PAPRST/digitensk/README.md

# Digital Ten GHz Super Keyer
Modern system for digital mode on 6 and 3cm HAM band
