PAPRST/digitensk/FrontEnd/DualMixer/Converter_Head/oshpark_stackup.png

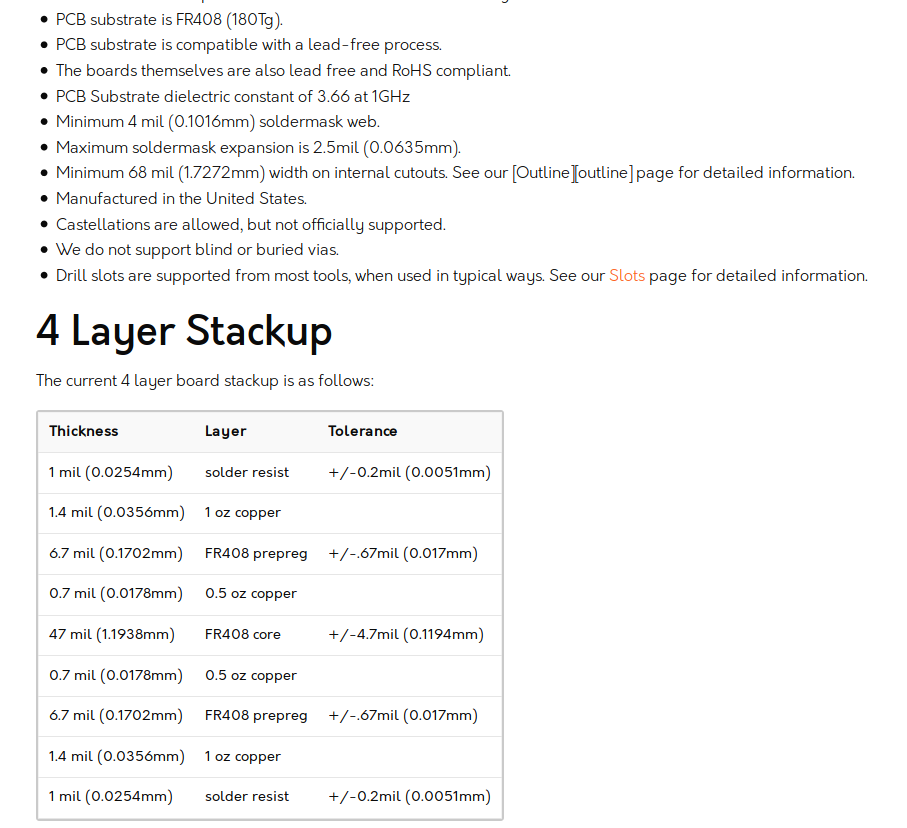
FrontEnd/DualMixer/Converter_Head/oshpark_stackup.png
