PAPRST/digitensk/FrontEnd/DualMixer/Converter_Head/Converter_Head_bom_1.0.csv

Component | Part | References | Value | Vendor | SKU | Footprint | Quantity Per PCB | Man. Ref. | Status
1 | CAP_0402 | C206 C208 C306 C308 | 0.15pF |  |  | SM0402 | 4
2 | CAP_0402 | C125 C127 C128 C129 C130 C131 C132 C133 C134 C137 C138 | 0.1uF |  |  | SM0402 | 11
3 | CAP_0603 | C114 | 1.68n |  |  | SM0603 | 1
4 | CAP_0603 | C410 C416 C417 C421 C422 C424 C430 C432 C437 | 100nF |  |  | SM0402 | 9
5 | CAP_0402 | C425 C426 C427 C428 | 100pF |  |  | SM0402 | 4
6 | CAP_0402 | C126 | 10nF |  |  | SM0402 | 1
7 | CAP_0402 | C135 C136 C411 C412 C418 C423 C429 C431 C433 C434 C435 C436 C438 | 10pF |  |  | SM0402 | 13
8 | CAP_1206 | C101 C102 C113 C116 C118 C119 | 10u |  |  | SM1206 | 6
9 | CAP_0805 | C103 C104 C110 C111 C401 C402 C403 C407 C408 C409 | 10uF |  |  | SM0805 | 10
10 | CAP_0402 | C415 | 1500pF |  |  | SM0402 | 1
11 | CAP_0402 | C419 C420 | 1n |  |  | SM0402 | 2
12 | CAP_0603 | C108 C109 C404 C405 C406 | 1nF |  |  | SM0603 | 5
13 | CAP_0603 | C203 C303 | 1uF |  |  | SM0603 | 2
14 | CAP_0603 | C107 | 2.8n |  |  | SM0603 | 1
15 | CAP_0402 | C205 C207 C209 C305 C307 C309 | 22pF |  |  | SM0402 | 6
16 | CAP_0402 | C201 C202 C301 C302 | 30pF |  |  | SM0402 | 4
17 | CAP_0402 | C414 | 33nF |  |  | SM0402 | 1
18 | CAP_0402 | C413 | 390pF |  |  | SM0402 | 1
19 | CAP_0603 | C112 | 4.7u |  |  | SM0603 | 1
20 | CAP_0603 | C105 C117 | 470p |  |  | SM0603 | 2
21 | CAP_0603 | C106 C115 | 47n |  |  | SM0603 | 2
22 | CAP_0402 | C204 C304 | 47pF |  |  | SM0402 | 2
23 | CAP_0402 | C444 C445 | CAP_0402 |  |  | SM0402 | 2
24 | CAP_0402 | C442 C443 C446 C447 | NC |  |  | SM0402 | 4
25 | LED | D101 D102 D103 D104 | LED |  |  | LED-0603 | 4
26 | BFCW | F201 F301 | BFCW-542+ |  |  | JC0603C | 2
27 | MINIC_HFCN | F403 F404 | MINIC_HFCN |  |  | FV1206 | 2
28 | MINIC_LFCN | F401 F402 | MINIC_LFCN |  |  | FV1206 | 2
29 | Conn_01x03 | J101 | Conn_01x03 |  |  | MOL_CONN_2_VH | 1
30 | Conn_01x06 | J105 | Conn_01x06 |  |  | PinHeader_1x06_P2.54mm_Vertical | 1
31 | Conn_02x03_Odd_Even | J104 | Conn_02x03_Odd_Even |  |  | PinHeader_2x03_P2.54mm_Vertical | 1
32 | Conn_02x06_Odd_Even | J103 J106 | Conn_02x06_Odd_Even |  |  | pin_array_6x2 | 2
33 | SMA_PCB | J102 J107 | SMA_PCB |  |  | SMA_RA_PCB_Amphenol | 2
34 | SMA_PCB | J201 J202 J301 J302 | SMA_PCB |  |  | PAD_T_200x110um | 4
35 | uFL | J401 J402 | uFL |  |  | U.FL-R-SMT-1 | 2
36 | TCM1-83X-1+ | K401 K402 | TCM1-83X-1+ |  |  | DB1627 | 2
37 | IND_SMALL | L101 L102 | 5.6uH |  |  | WE-HCI_SMD_5.6x5.3x4 | 2 | 744316560
38 | IND_0402 | L401 L402 L403 L404 | 7.5nH |  |  | SM0402 | 4
39 | IND_0402 | L104 | IND_0402 |  |  | SM0402 | 1
40 | IND_0603 | L201 L202 L203 L301 L302 L303 | IND_0603 |  |  | SM0603 | 6
41 | BSS138 | Q101 | BSS138 |  |  | SOT-23 | 1
42 | RES_1206 | R101 R110 | 0 |  |  | SM1206 | 2
43 | RES_0402 | R117 R118 R119 | 0 |  |  | SM0402 | 3
44 | RES_0603 | R129 R130 R131 R132 | 0 |  |  | SM0603 | 4
45 | RES_0603 | R104 R107 | 10 |  |  | SM0603 | 2
46 | RES_0603 | R124 R128 R133 R134 | 100 |  |  | SM0603 | 4
47 | RES_0603 | R111 R112 R121 R122 R123 R126 R127 | 10k |  |  | SM0603 | 7
48 | RES_0402 | R402 | 1k |  |  | SM0402 | 1
49 | RES_0603 | R102 R108 | 20.5k |  |  | SM0603 | 2
50 | RES_0603 | R125 | 2000k |  |  | SM0603 | 1
51 | RES_0603 | R103 | 3.48k |  |  | SM0603 | 1
52 | RES_0603 | R105 | 34.8k |  |  | SM0603 | 1
53 | RES_0402 | R403 | 4.7k |  |  | SM0402 | 1
54 | RES_0402 | R116 | 50 |  |  | SM0402 | 1
55 | RES_0603 | R106 | 57.6k |  |  | SM0603 | 1
56 | RES_0603 | R109 | 6.49k |  |  | SM0603 | 1
57 | RES_0402 | R114 R115 R120 | NC |  |  | SM0402 | 3
58 | RES_0402 | R401 | RES_0402 |  |  | SM0402 | 1
59 | ADF4355 | U404 | ADF4355 |  |  | QFN32_5x5mm_3.6mm | 1 |  | OK
60 | ADM7170 | U101 U102 U402 U403 | ADM7170ACPZ-3.3 | MOUSER | 584-ADM7170ACPZ3.3R7 | DFN8_3x3mm | 4
61 | ADM7170 | U401 | ADM7170ACPZ-5.0 | MOUSER | 584-ADM7170ACPZ5.0R7 | DFN8_3x3mm | 1
62 | ATmega328PB-AU | U106 | ATmega328PB-AU | MOUSER | 556-ATMEGA328PB-AU | TQFP-32_7x7mm_P0.8mm | 1
63 | LTC5549 | U201 U301 | LTC5549 |  |  | QFN12_2x3mm_UDB_LT | 2
64 | LTC6957IMS-3 | U104 | LTC6957IMS-3 | MOUSER | 584-LTC6957IMS-3#PBF | MSOP-12_3x4mm_P0.65mm | 1
65 | PCA9306DCT_SSOP | U105 | PCA9306DCT_SSOP |  |  | SSOP8 | 1
66 | SN74LV4T125 | U107 | SN74LV4T125 |  |  | TSSOP-14_4.4x5mm_P0.65mm | 1
67 | TPS5429x | U103 | TPS54292 |  |  | PowerPad_TSSOP_16 | 1
68 | SMD_XTAL_small | X101 | 8MHz |  |  | xtal_3.2x2.5 | 1
Component Groups: | 68
Component Count: | 184
Fitted Components: | 184
Number of PCBs: | 1
Total components: | 184
Schematic Version: | 1.0
Schematic Date: | 2020-10-04
PCB Variant: | [u'default']
BoM Date: | lun. 14 juin 2021 23:31:11
Schematic Source: | /home/nats/data/projects/digitensk/FrontEnd/DualMixer/Converter_Head/Converter_Head.sch
KiCad Version: | Eeschema 5.1.9-73d0e3b20d~88~ubuntu18.04.1
