PAPRST/digitensk/FrontEnd/DualMixer/documents/Converter_Head.pdf

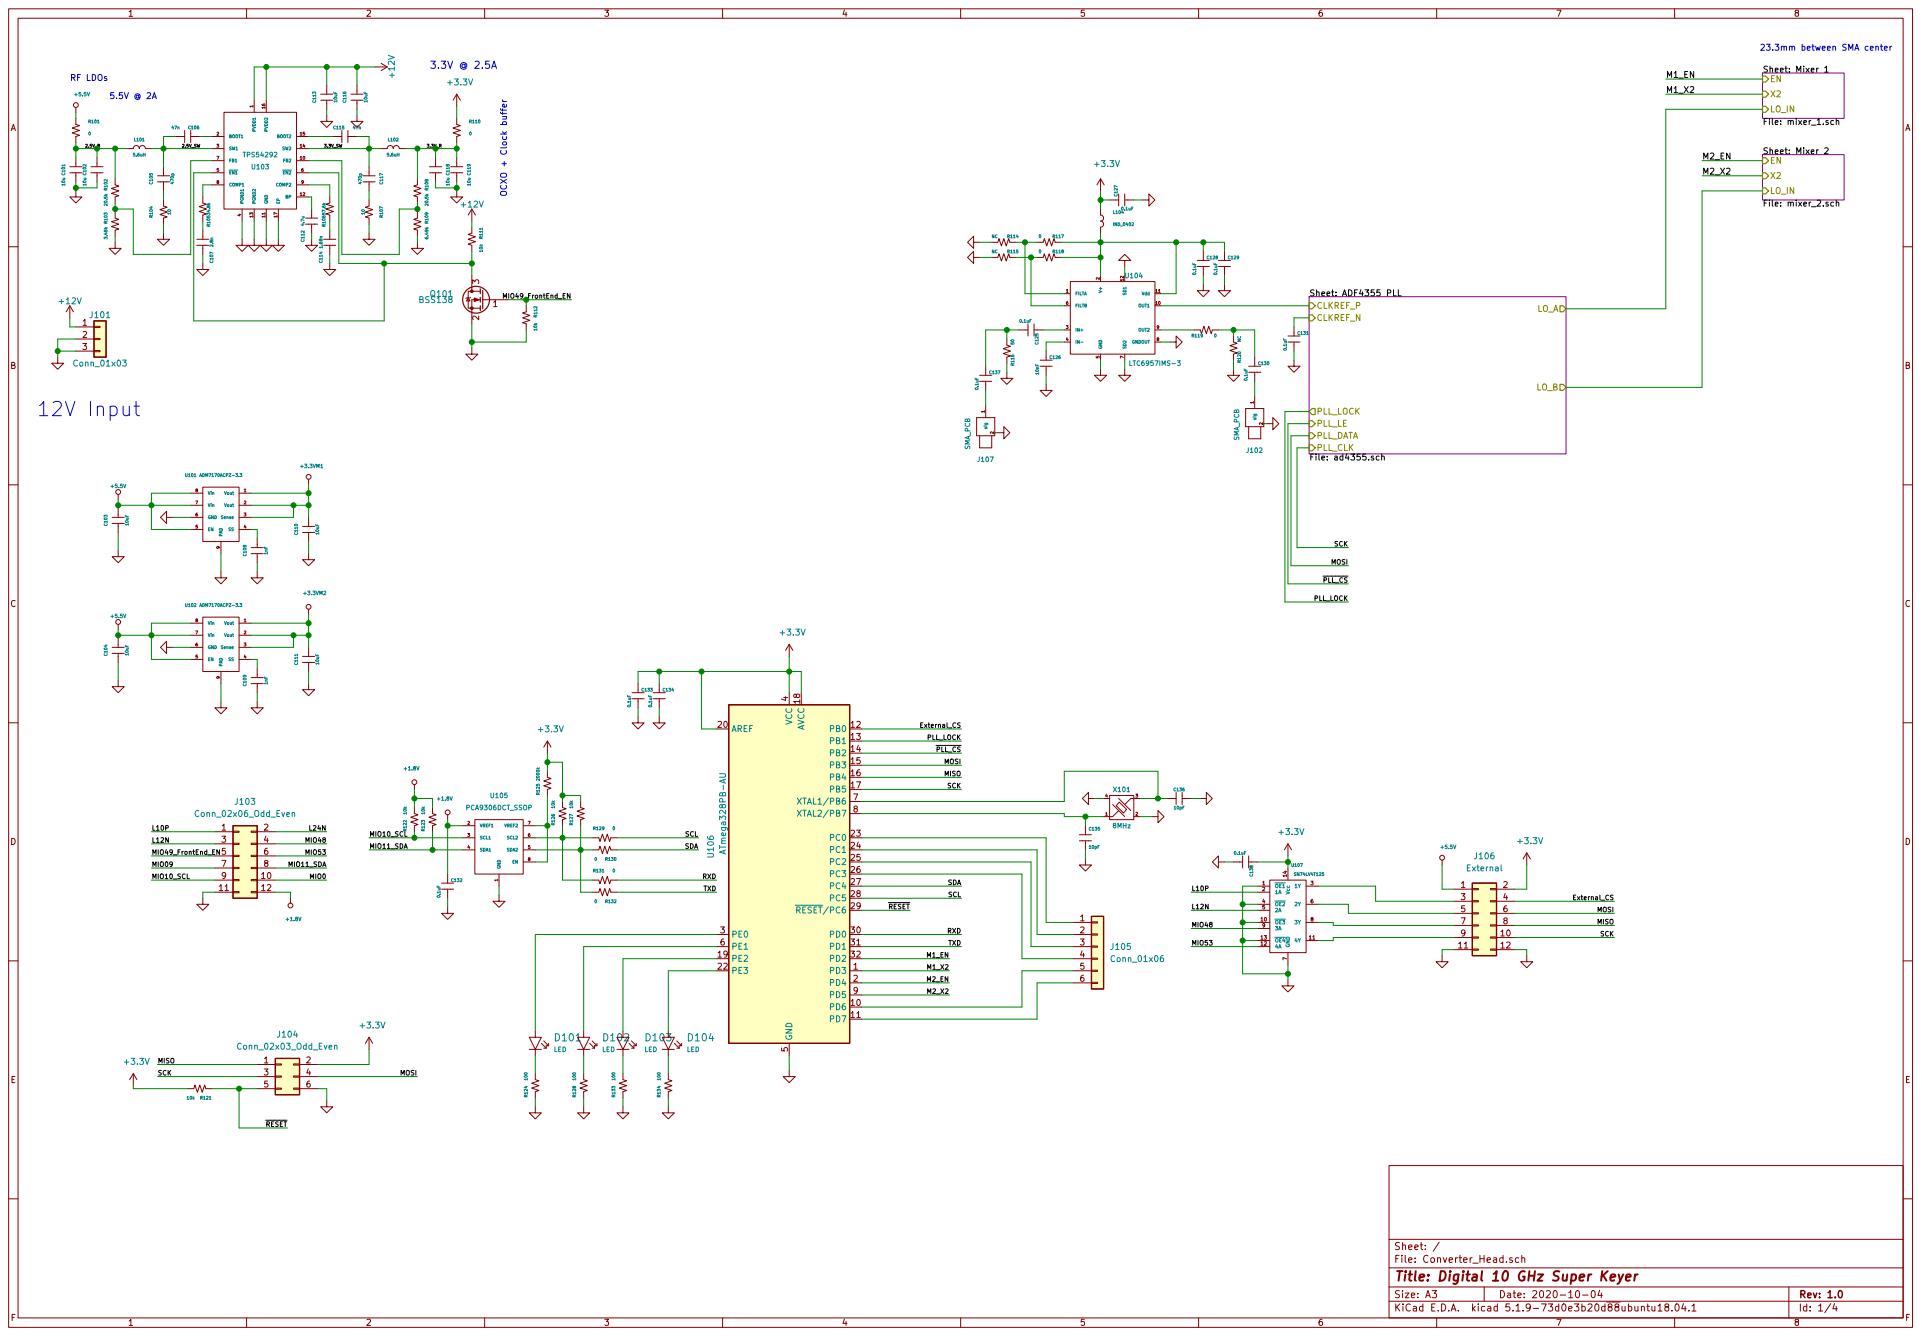
[picture p2: page 1]

23.3mm between SMA center OCXO + Clock buffer

Sheet: Mixer 1 File: mixer_1.sch

Sheet: Mixer 2 File: mixer_2.sch

File: Converter_Head.sch Sheet: /
Id: 1/4 Title: Digital 10 GHz Super Keyer

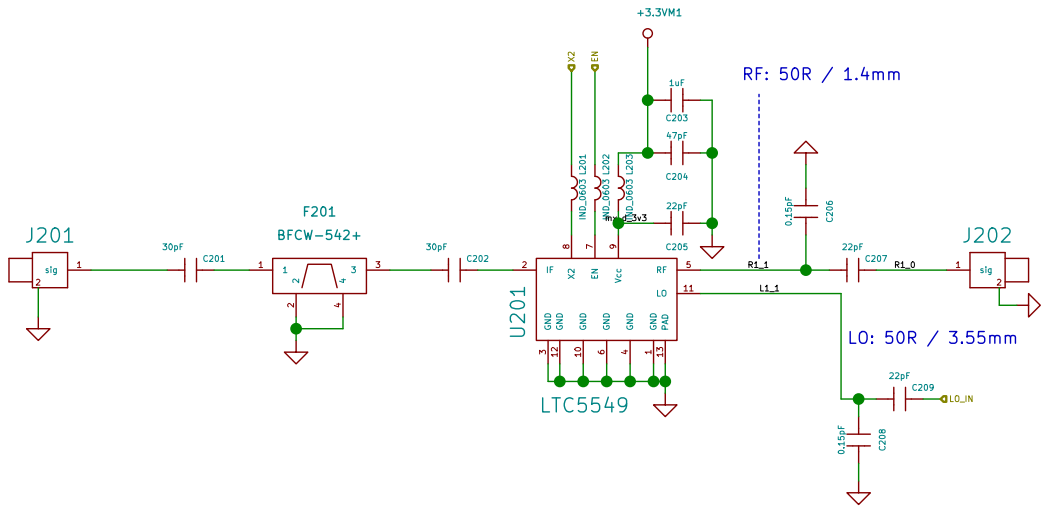
[picture p3: page 2]

Id: 2/4 Title: Digital 10 GHz Super Keyer

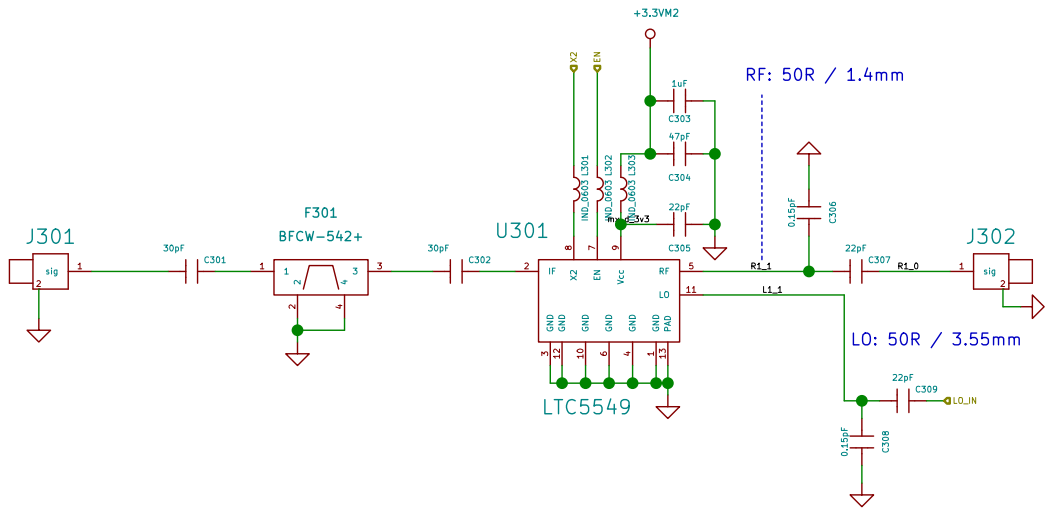
[picture p4: page 3]

Id: 3/4 Title: Digital 10 GHz Super Keyer

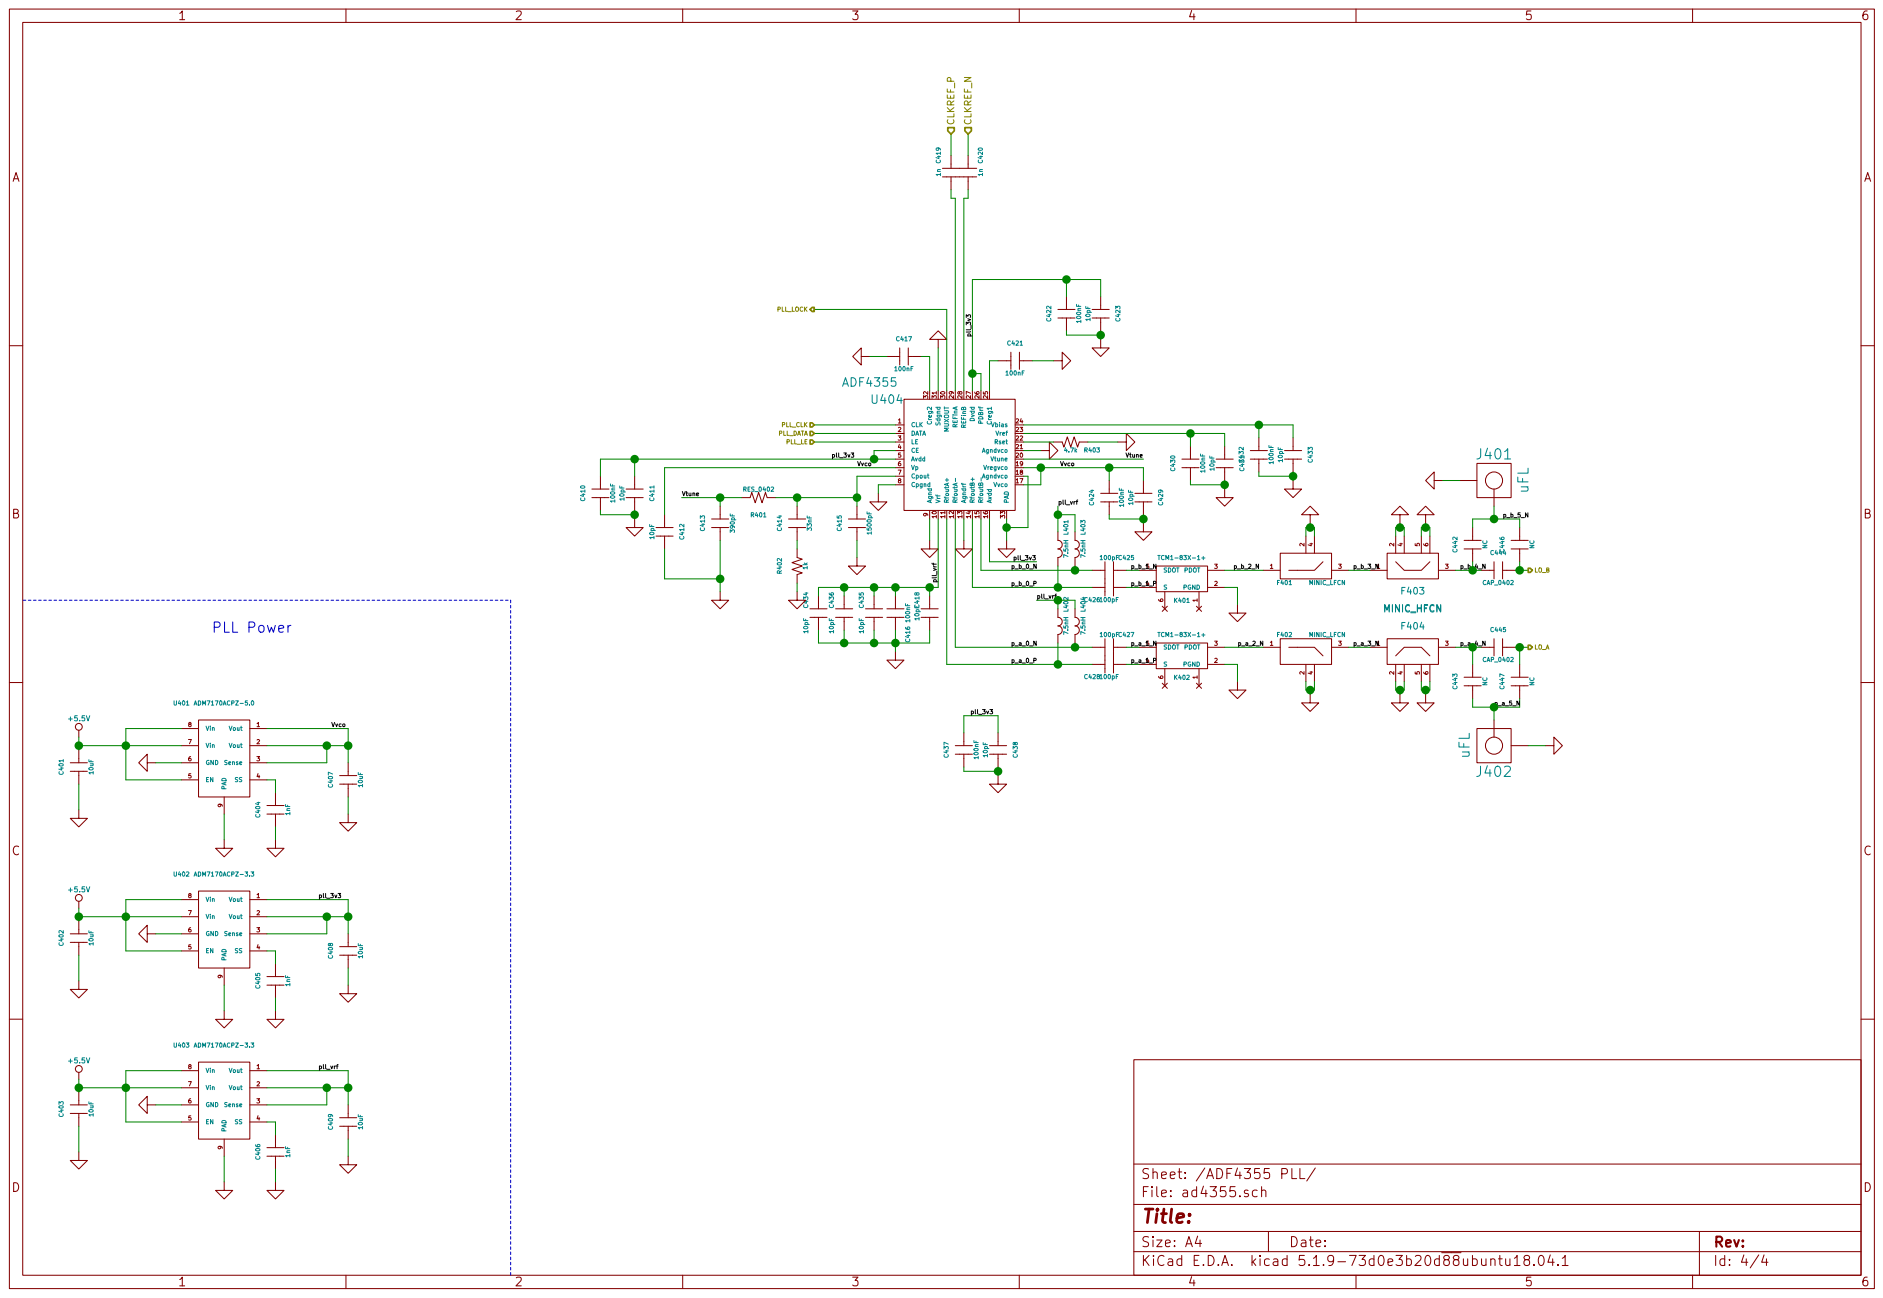
[picture p5: page 4]

Vvco | Vvco
