PAPRST/digitensk/FrontEnd/DualMixer/Converter_Head/Converter_Head.kicad_pcb

## KiCad design FrontEnd/DualMixer/Converter_Head/Converter_Head.kicad_pcb (2021-07-17)

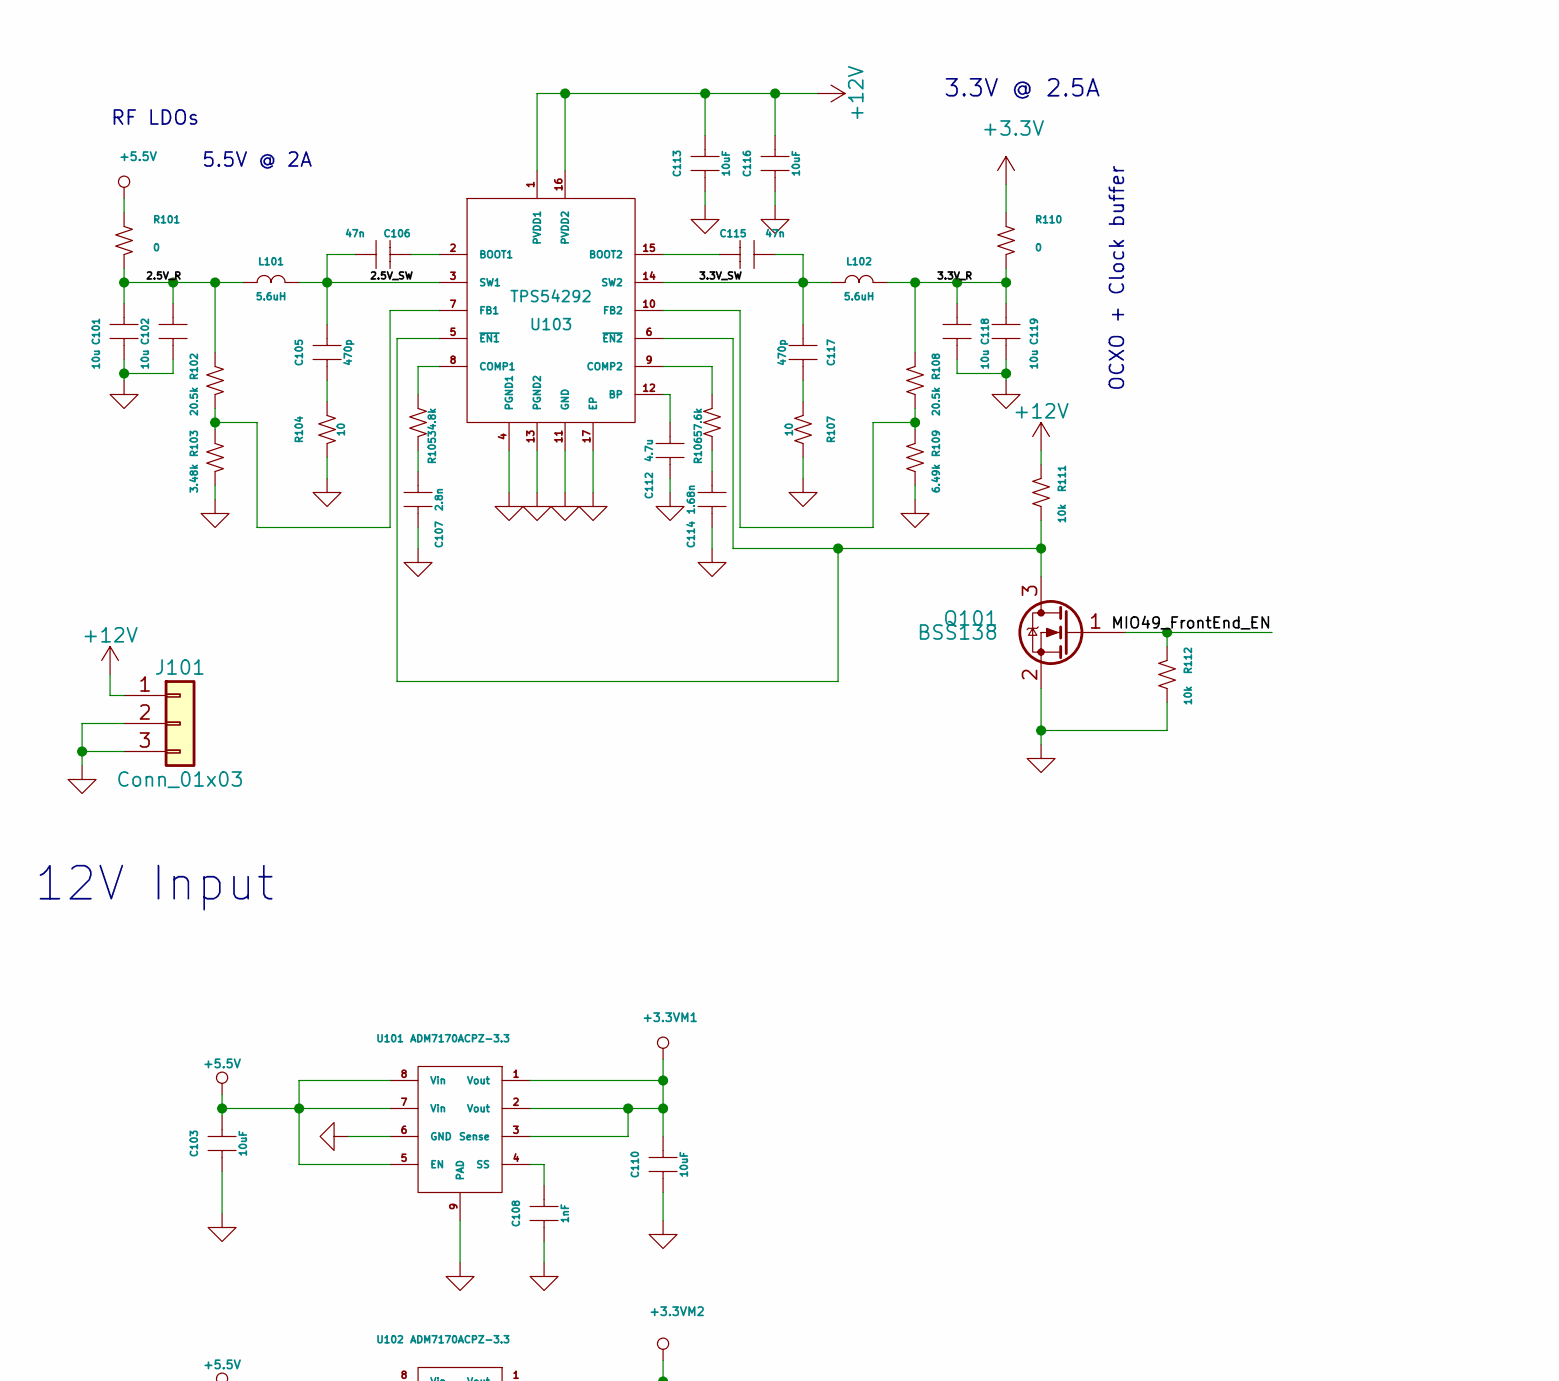
[picture p6: schematic Converter_Head.sch, Digital 10 GHz Super Keyer, part in row 1, column 1]

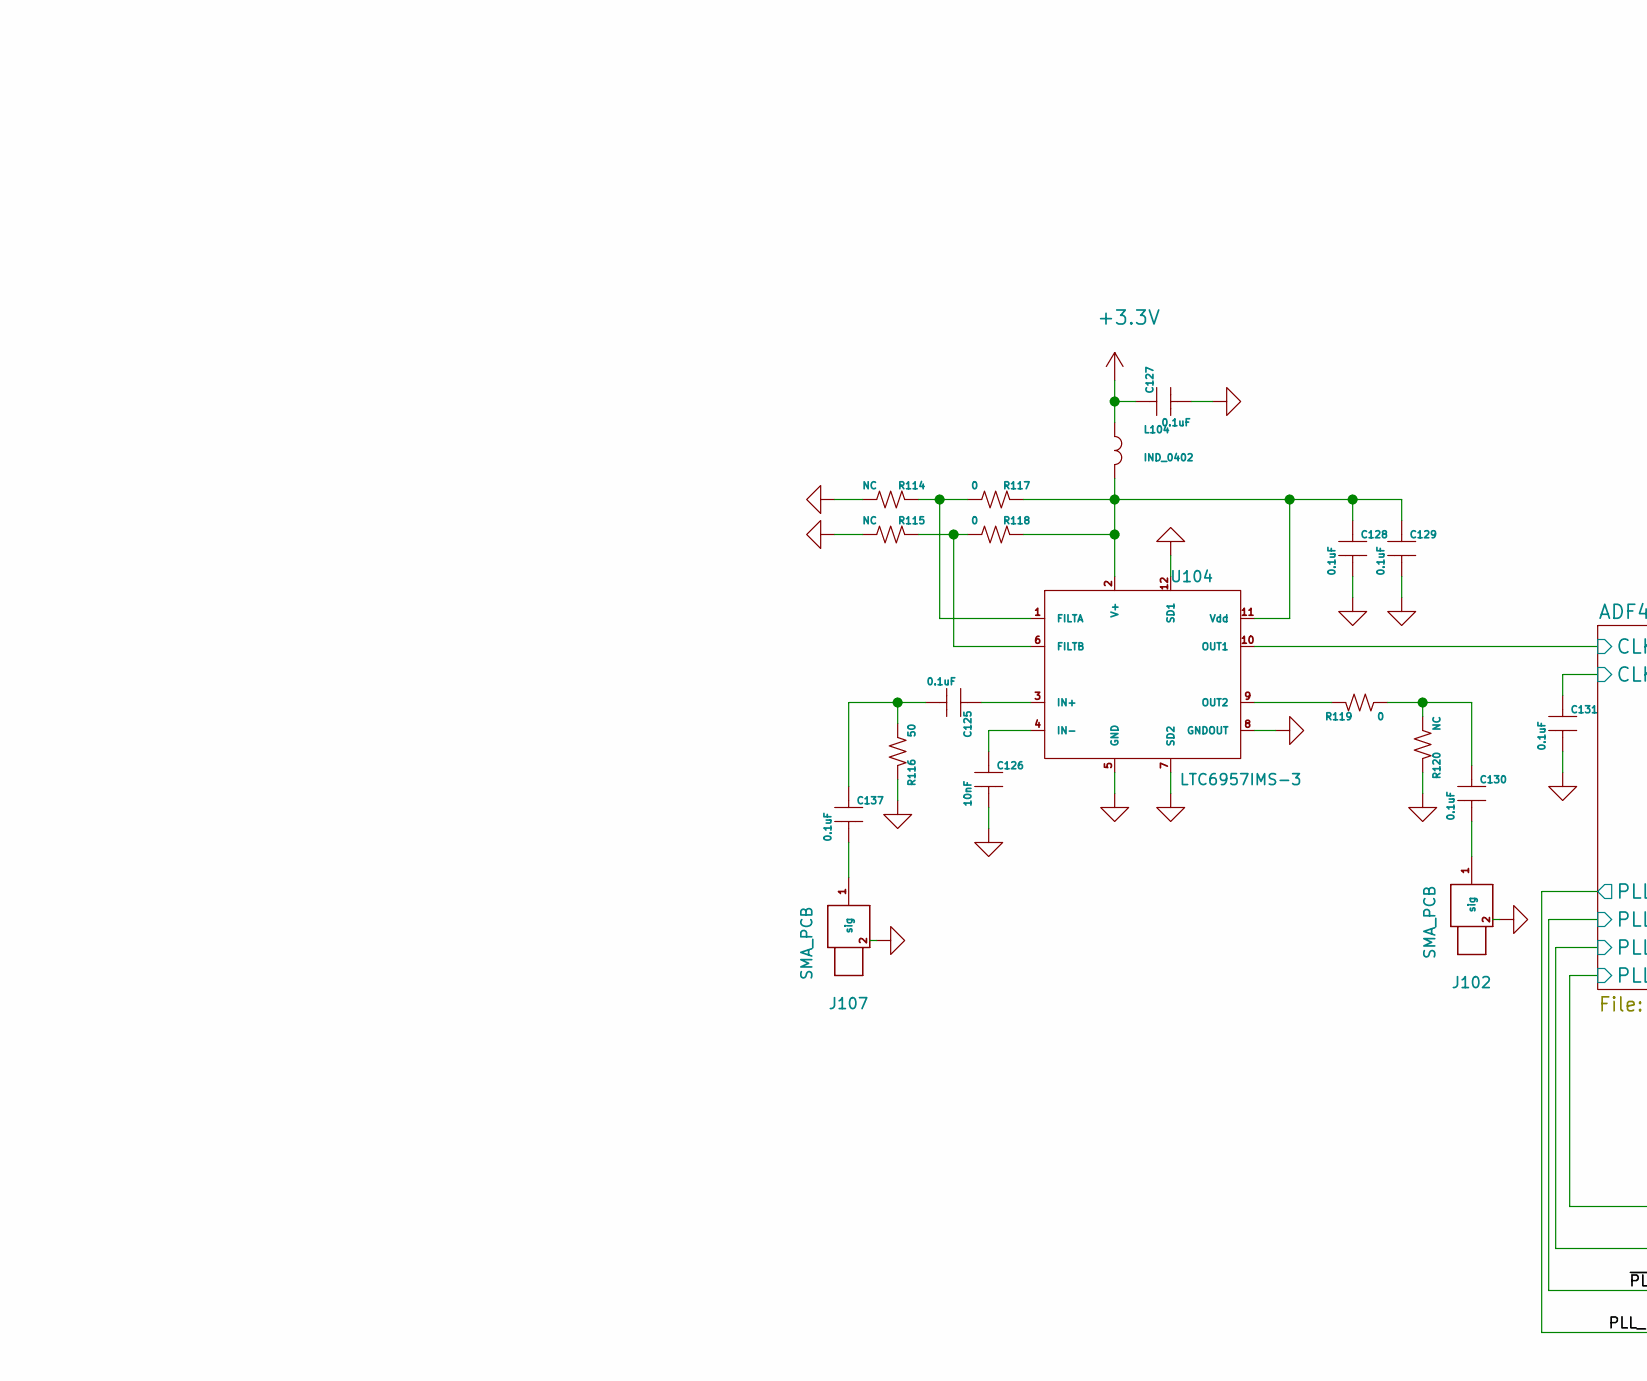
[picture p7: schematic Converter_Head.sch, Digital 10 GHz Super Keyer, part in row 1, column 2]

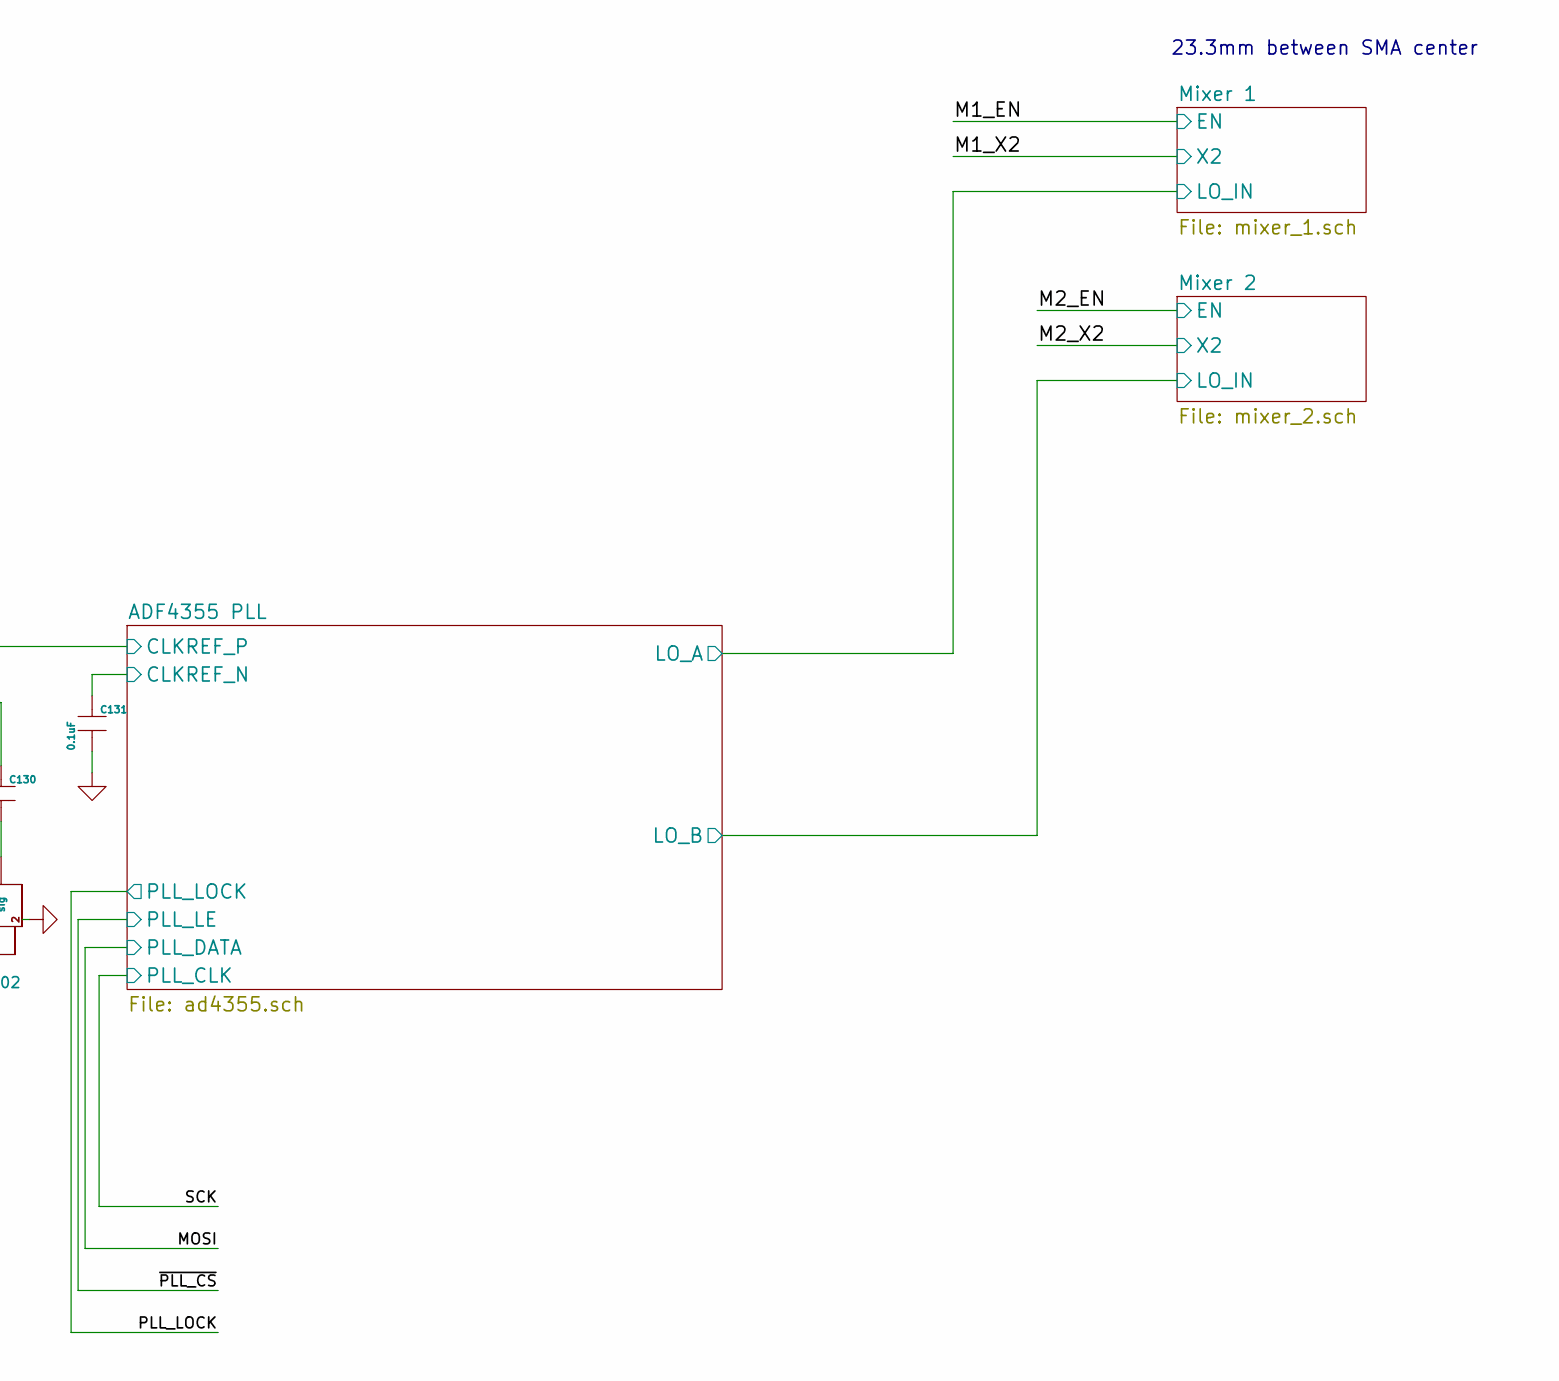
[picture p8: schematic Converter_Head.sch, Digital 10 GHz Super Keyer, part in row 1, column 3]

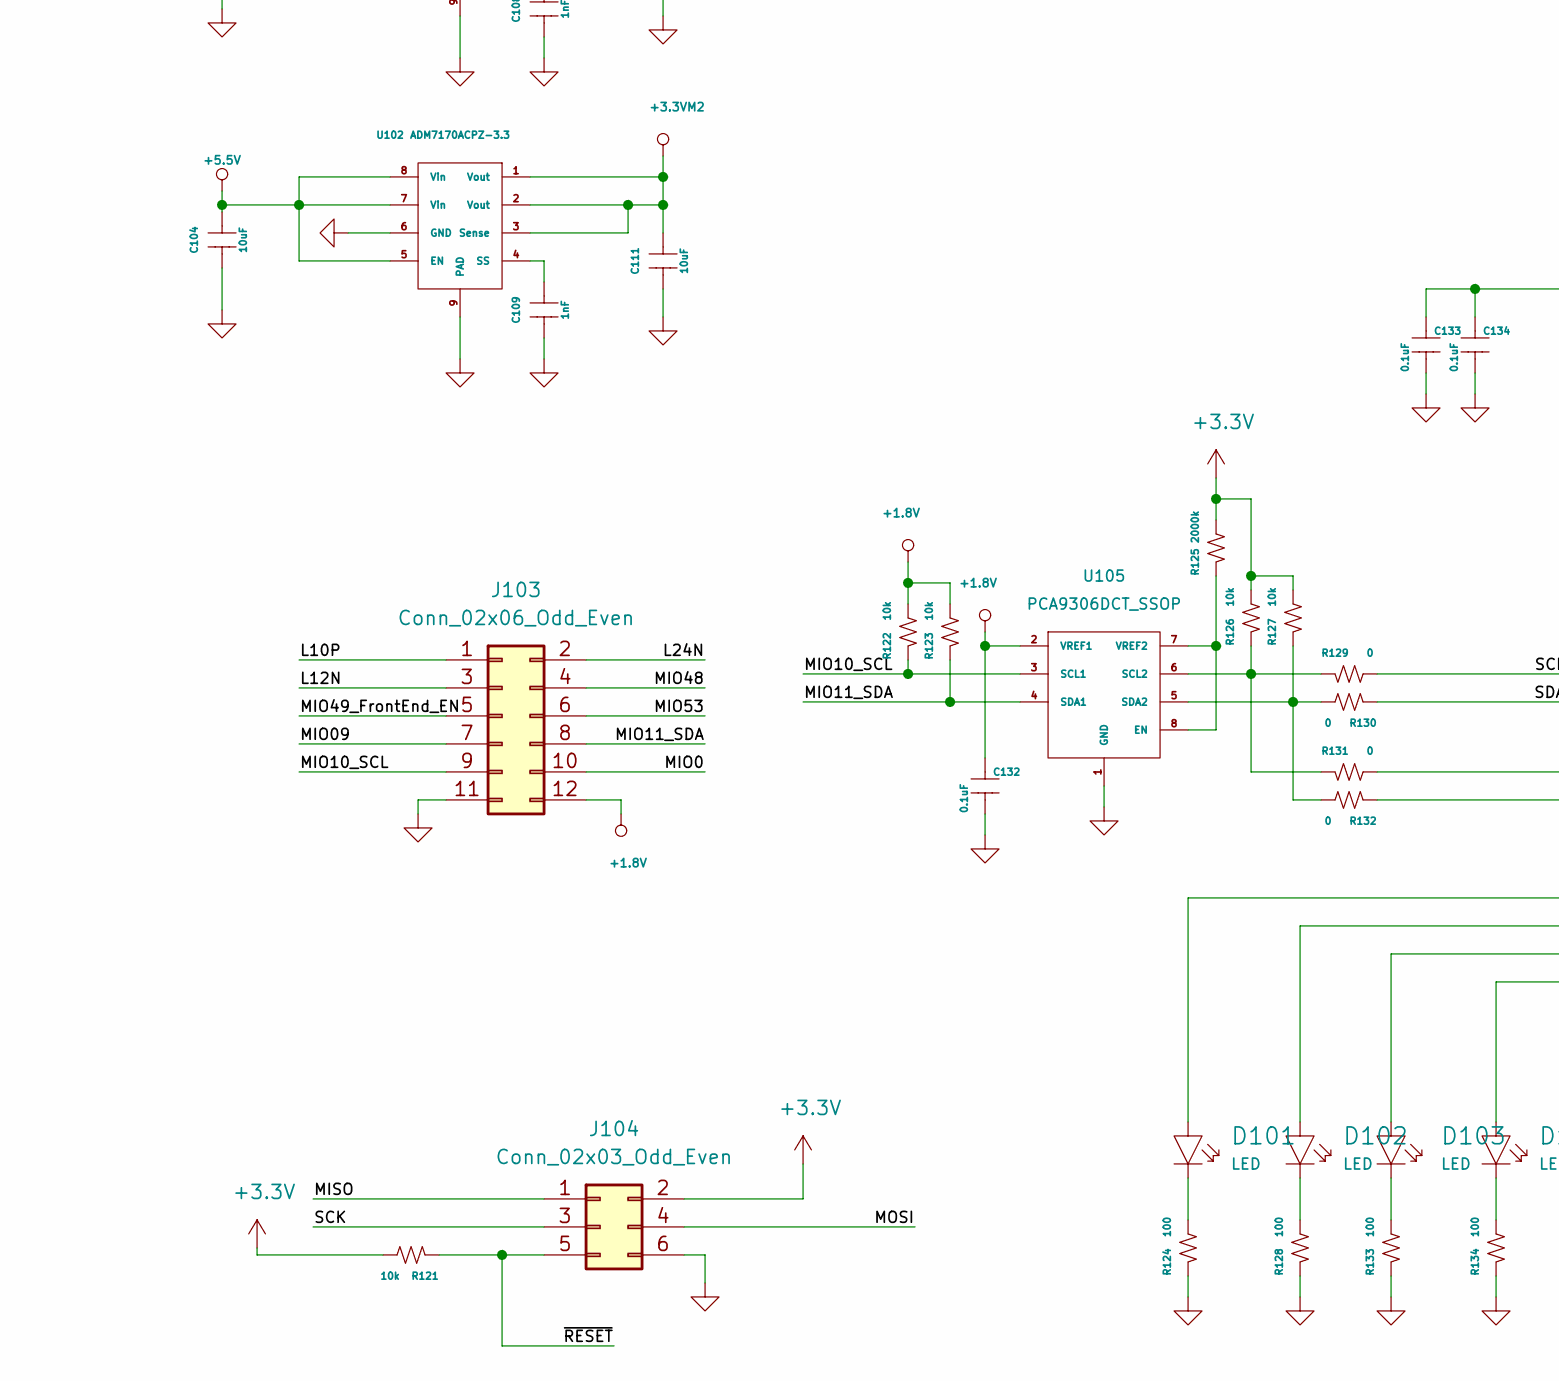
[picture p9: schematic Converter_Head.sch, Digital 10 GHz Super Keyer, part in row 2, column 1]

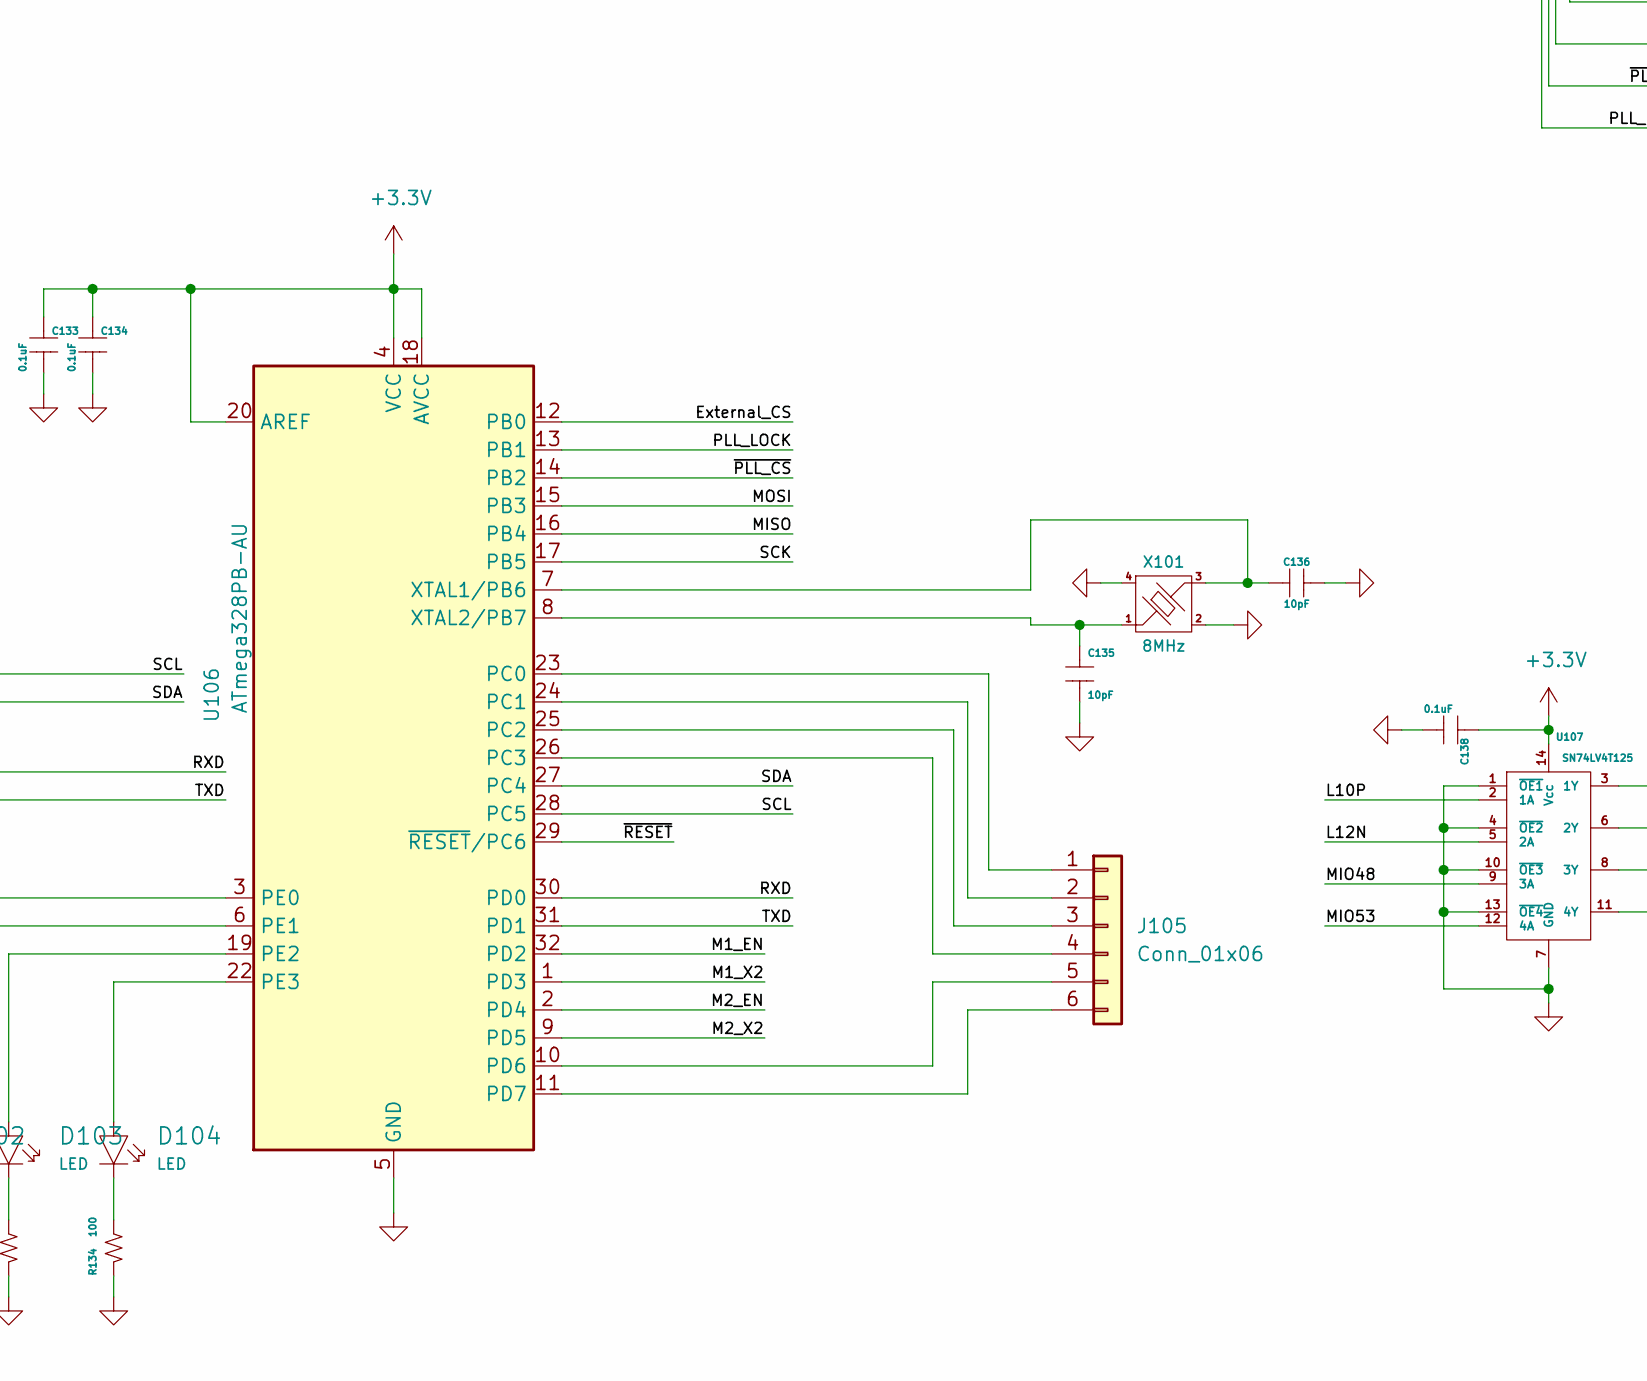
[picture p10: schematic Converter_Head.sch, Digital 10 GHz Super Keyer, part in row 2, column 2]

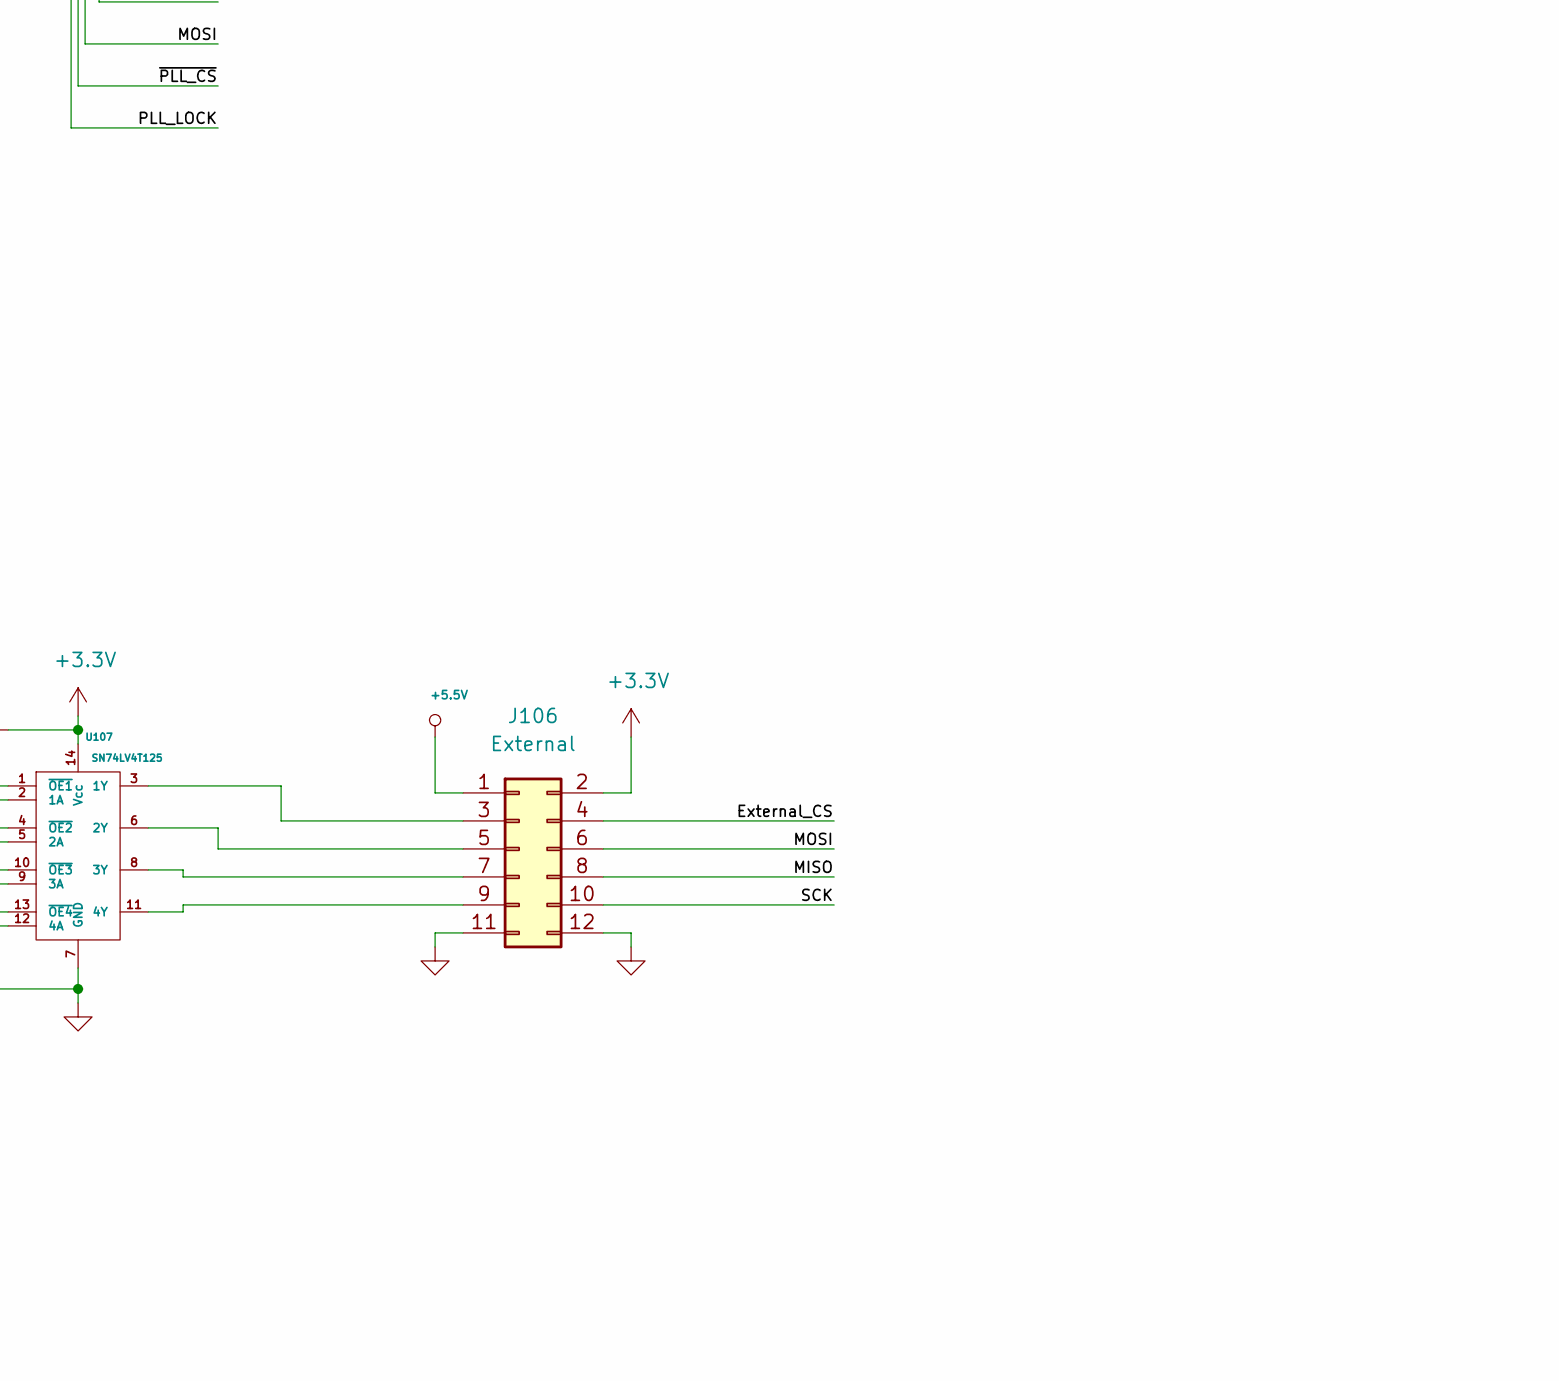
[picture p11: schematic Converter_Head.sch, Digital 10 GHz Super Keyer, part in row 2, column 3]

Parts:
C101, C102, C118, C119: 10u; SM1206
C103, C104, C110, C111: 10uF; SM0805
C105, C117: 470p; SM0603
C106, C115: 47n; SM0603
C107: 2.8n; SM0603
C108, C109: 1nF; SM0603
C112: 4.7u; SM0603
C113, C116: 10uF; SM1206
C114: 1.68n; SM0603
C125, C127, C128, C129, C130, C131, C132, C133, C134, C137, C138: 0.1uF; SM0402
C126: 10nF; SM0402
C135, C136: 10pF; SM0402
D101, D102, D103, D104: LED; LED-0603
J101: Conn_01x03; MOL_CONN_2_VH
J102, J107: SMA_PCB; SMA_RA_PCB_Amphenol
J103: Conn_02x06_Odd_Even; pin_array_6x2
J104: Conn_02x03_Odd_Even; PinHeader_2x03_P2.54mm_Vertical
J105: Conn_01x06; PinHeader_1x06_P2.54mm_Vertical
J106: External; pin_array_6x2
L101, L102: 5.6uH; WE-HCI_SMD_5.6x5.3x4
L104: IND_0402; SM0402
Q101: BSS138; SOT-23
R101, R110: 0; SM1206
R102, R108: 20.5k; SM0603
R103: 3.48k; SM0603
R104, R107: 10; SM0603
R105: 34.8k; SM0603
R106: 57.6k; SM0603
R109: 6.49k; SM0603
R111, R112, R121, R122, R123, R126, R127: 10k; SM0603
R114, R115, R120: NC; SM0402
R116: 50; SM0402
R117, R118, R119: 0; SM0402
R124, R128, R133, R134: 100; SM0603
R125: 2000k; SM0603
R129, R130, R131, R132: 0; SM0603
U101, U102: ADM7170ACPZ-3.3; DFN8_3x3mm
U103: TPS54292; PowerPad_TSSOP_16
U104: LTC6957IMS-3; MSOP-12_3x4mm_P0.65mm
U105: PCA9306DCT_SSOP; SSOP8
U106: ATmega328PB-AU; TQFP-32_7x7mm_P0.8mm
U107: SN74LV4T125; TSSOP-14_4.4x5mm_P0.65mm
X101: 8MHz; xtal_3.2x2.5

Connections:
+1.8V: C132.1, J103.12, R122.2, R123.2, U105.2 (VREF1)
+3.3VM1: C110.1, U101.1 (Vout), U101.2 (Vout), U101.3 (Sense); also elsewhere on the board
+3.3VM2: C111.1, U102.1 (Vout), U102.2 (Vout), U102.3 (Sense); also elsewhere on the board
+3V3: C127.1, C133.1, C134.1, C138.1, J104.2, J106.2, L104.1, R110.1, R121.2, R125.2, R126.2, R127.2, U106.4 (VCC), U106.18 (AVCC), U106.20 (AREF), U107.14 (Vcc)
+5.5V: C103.1, C104.1, J106.1, R101.1, U101.5 (EN), U101.7 (Vin), U101.8 (Vin), U102.5 (EN), U102.7 (Vin), U102.8 (Vin); also elsewhere on the board
+12V: C113.1, C116.1, J101.1, R111.1, U103.1 (PVDD1), U103.16 (PVDD2)
/2.5V_R: C101.1, C102.1, L101.1, R101.2, R102.1
/2.5V_SW: C105.1, C106.1, L101.2, U103.3 (SW1)
/3.3V_R: C118.1, C119.1, L102.1, R108.1, R110.2
/3.3V_SW: C115.1, C117.1, L102.2, U103.14 (SW2)
/ADF4355 PLL/CLKREF_N: C131.1; also elsewhere on the board
/ADF4355 PLL/CLKREF_P: U104.10 (OUT1); also elsewhere on the board
/External_CS: J106.4, U106.12 (PB0)
/L10P: J103.1, U107.2 (1A)
/L12N: J103.3, U107.5 (2A)
/L24N: J103.2
/M1_EN: U106.32 (PD2); also elsewhere on the board
/M1_X2: U106.1 (PD3); also elsewhere on the board
/M2_EN: U106.2 (PD4); also elsewhere on the board
/M2_X2: U106.9 (PD5); also elsewhere on the board
/MIO0: J103.10
/MIO09: J103.7
/MIO10_SCL: J103.9, R122.1, U105.3 (SCL1)
/MIO11_SDA: J103.8, R123.1, U105.4 (SDA1)
/MIO48: J103.4, U107.9 (3A)
/MIO49_FrontEnd_EN: J103.5, Q101.1 (G), R112.1
/MIO53: J103.6, U107.12 (4A)
/MISO: J104.1, J106.8, U106.16 (PB4)
/MOSI: J104.4, J106.6, U106.15 (PB3); also elsewhere on the board
/PLL_LOCK: U106.13 (PB1); also elsewhere on the board
/RXD: R131.2, U106.30 (PD0)
/SCK: J104.3, J106.10, U106.17 (PB5); also elsewhere on the board
/SCL: R129.2, U106.28 (PC5)
/SDA: R130.1, U106.27 (PC4)
/TXD: R132.1, U106.31 (PD1)
/~PLL_CS: U106.14 (PB2); also elsewhere on the board
/~RESET: J104.5, R121.1, U106.29 (~RESET~/PC6)
GND: C101.2, C102.2, C103.2, C104.2, C107.2, C108.2, C109.2, C110.2, C111.2, C112.2, C113.2, C114.2, C116.2, C118.2, C119.2, C126.2, C127.2, C128.2, C129.2, C131.2, C132.2, C133.2, C134.2, C135.2, C136.2, C138.2, J101.2, J101.3, J102.2, J103.11, J104.6, J106.11, J106.12, J107.2, Q101.2 (S), R103.2, R104.2, R107.2, R109.2, R112.2, R114.1, R115.1, R116.2, R120.2, R124.1, R128.1, R133.1, R134.1, U101.6 (GND), U101.9 (PAD), U102.6 (GND), U102.9 (PAD), U103.4 (PGND1), U103.11 (GND), U103.13 (PGND2), U103.17 (EP), U104.5 (GND), U104.7 (SD2), U104.8 (GNDOUT), U104.12 (SD1), U105.1 (GND), U106.5 (GND), U106.21 (GND), U107.1 (~OE1), U107.4 (~OE2), U107.7 (GND), U107.10 (~OE3), U107.13 (~OE4), X101.2, X101.4; also elsewhere on the board
unnamed: C105.2, R104.1
unnamed: C106.2, U103.2 (BOOT1)
unnamed: C107.1, R105.2
unnamed: C108.1, U101.4 (SS)
unnamed: C109.1, U102.4 (SS)
unnamed: C112.1, U103.12 (BP)
unnamed: C114.1, R106.2
unnamed: C115.2, U103.15 (BOOT2)
unnamed: C117.2, R107.1
unnamed: C125.1, U104.3 (IN+)
unnamed: C125.2, C137.1, R116.1
unnamed: C126.1, U104.4 (IN-)
unnamed: C128.1, C129.1, L104.2, R117.2, R118.2, U104.2 (V+), U104.11 (Vdd)
unnamed: C130.1, R119.1, R120.1
unnamed: C130.2, J102.1 (sig)
unnamed: C135.1, U106.8 (XTAL2/PB7), X101.1
unnamed: C136.1, U106.7 (XTAL1/PB6), X101.3
unnamed: C137.2, J107.1 (sig)
unnamed: D101.A, U106.3 (PE0)
unnamed: D101.K, R124.2
unnamed: D102.A, U106.6 (PE1)
unnamed: D102.K, R128.2
unnamed: D103.A, U106.19 (PE2)
unnamed: D103.K, R133.2
unnamed: D104.A, U106.22 (PE3)
unnamed: D104.K, R134.2
unnamed: J105.1, U106.23 (PC0)
unnamed: J105.2, U106.24 (PC1)
unnamed: J105.3, U106.25 (PC2)
unnamed: J105.4, U106.26 (PC3)
unnamed: J105.5, U106.10 (PD6)
unnamed: J105.6, U106.11 (PD7)
unnamed: J106.3, U107.3 (1Y)
unnamed: J106.5, U107.6 (2Y)
unnamed: J106.7, U107.8 (3Y)
unnamed: J106.9, U107.11 (4Y)
unnamed: Q101.3 (D), R111.2, U103.5 (~EN1), U103.6 (~EN2)
unnamed: R102.2, R103.1, U103.7 (FB1)
unnamed: R105.1, U103.8 (COMP1)
unnamed: R106.1, U103.9 (COMP2)
unnamed: R108.2, R109.1, U103.10 (FB2)
unnamed: R114.2, R117.1, U104.1 (FILTA)
unnamed: R115.2, R118.1, U104.6 (FILTB)
unnamed: R119.2, U104.9 (OUT2)
unnamed: R125.1, U105.7 (VREF2), U105.8 (EN)
unnamed: R126.1, R129.1, R131.1, U105.6 (SCL2)
unnamed: R127.1, R130.2, R132.2, U105.5 (SDA2)

Notes on the sheet:
12V Input
3.3V @ 2.5A
OCXO + Clock buffer
RF LDOs
5.5V @ 2A
23.3mm between SMA center

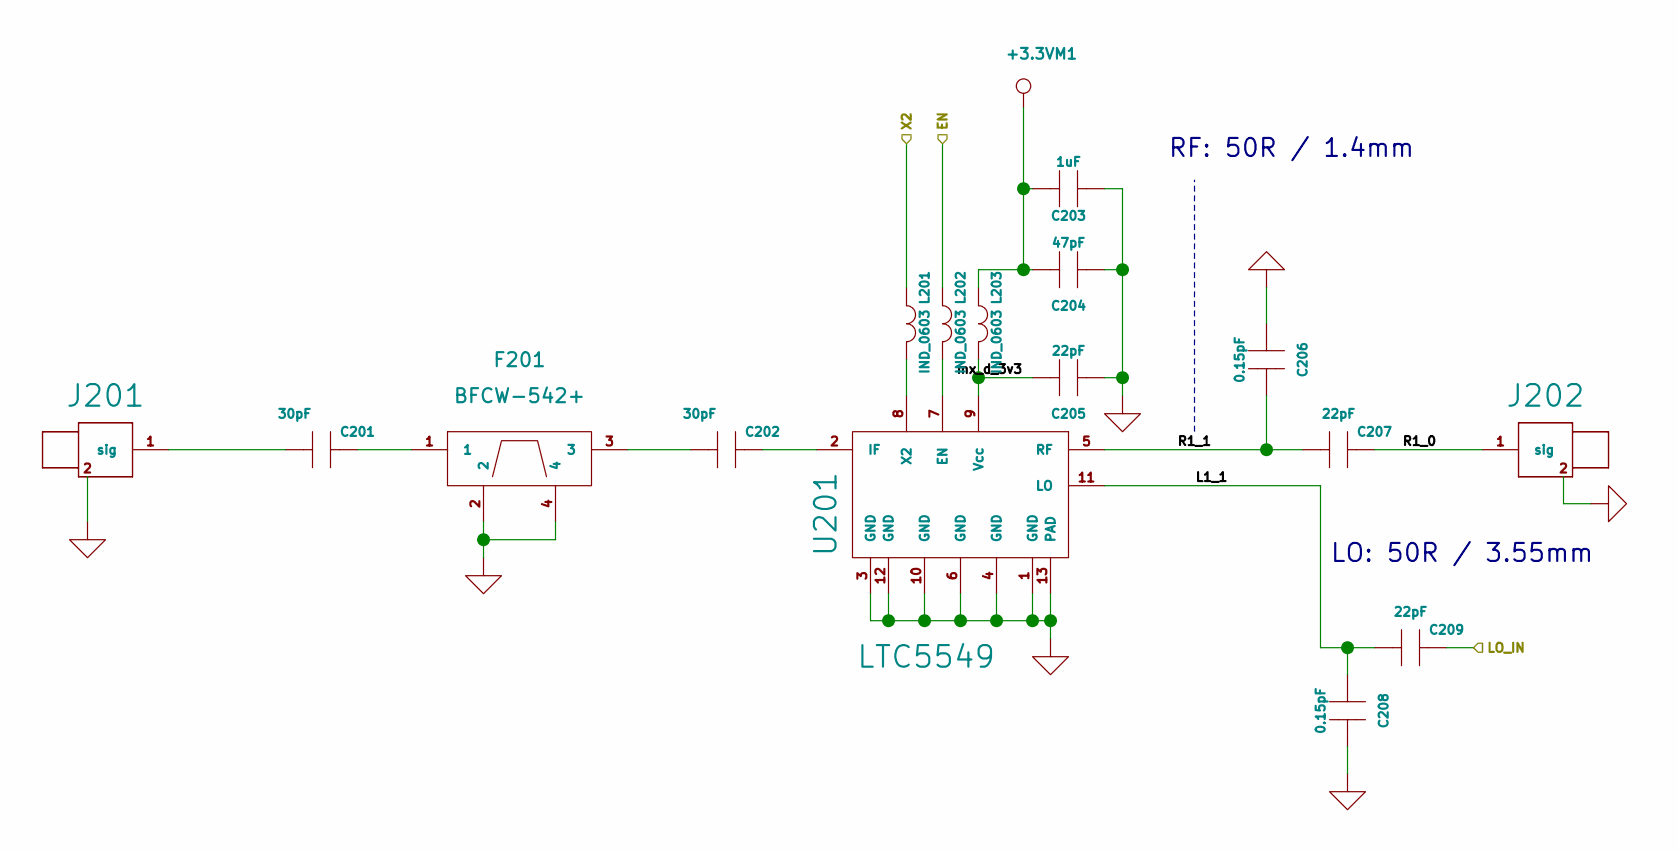
[picture p12: schematic mixer_1.sch, Digital 10 GHz Super Keyer]

Parts:
C201, C202: 30pF; SM0402
C203: 1uF; SM0603
C204: 47pF; SM0402
C205, C207, C209: 22pF; SM0402
C206, C208: 0.15pF; SM0402
F201: BFCW-542+; JC0603C
J201, J202: SMA_PCB; PAD_T_200x110um
L201, L202, L203: IND_0603; SM0603
U201: LTC5549; QFN12_2x3mm_UDB_LT

Connections:
+3.3VM1: C203.1, C204.2, L203.2; also elsewhere on the board
/ADF4355 PLL/LO_A: C209.1; also elsewhere on the board
/M1_EN: L202.2; also elsewhere on the board
/M1_X2: L201.2; also elsewhere on the board
/Mixer 1/L1_1: C208.1, C209.2, U201.11 (LO)
/Mixer 1/R1_0: C207.1, J202.1 (sig)
/Mixer 1/R1_1: C206.2, C207.2, U201.5 (RF)
/Mixer 1/mx_d_3v3: C205.2, L203.1, U201.9 (Vcc)
GND: C203.2, C204.1, C205.1, C206.1, C208.2, F201.2, F201.4, J201.2, J202.2, U201.1 (GND), U201.3 (GND), U201.4 (GND), U201.6 (GND), U201.10 (GND), U201.12 (GND), U201.13 (PAD); also elsewhere on the board
unnamed: C201.1, F201.1
unnamed: C201.2, J201.1 (sig)
unnamed: C202.1, U201.2 (IF)
unnamed: C202.2, F201.3
unnamed: L201.1, U201.8 (X2)
unnamed: L202.1, U201.7 (EN)

Notes on the sheet:
LO: 50R / 3.55mm
RF: 50R / 1.4mm

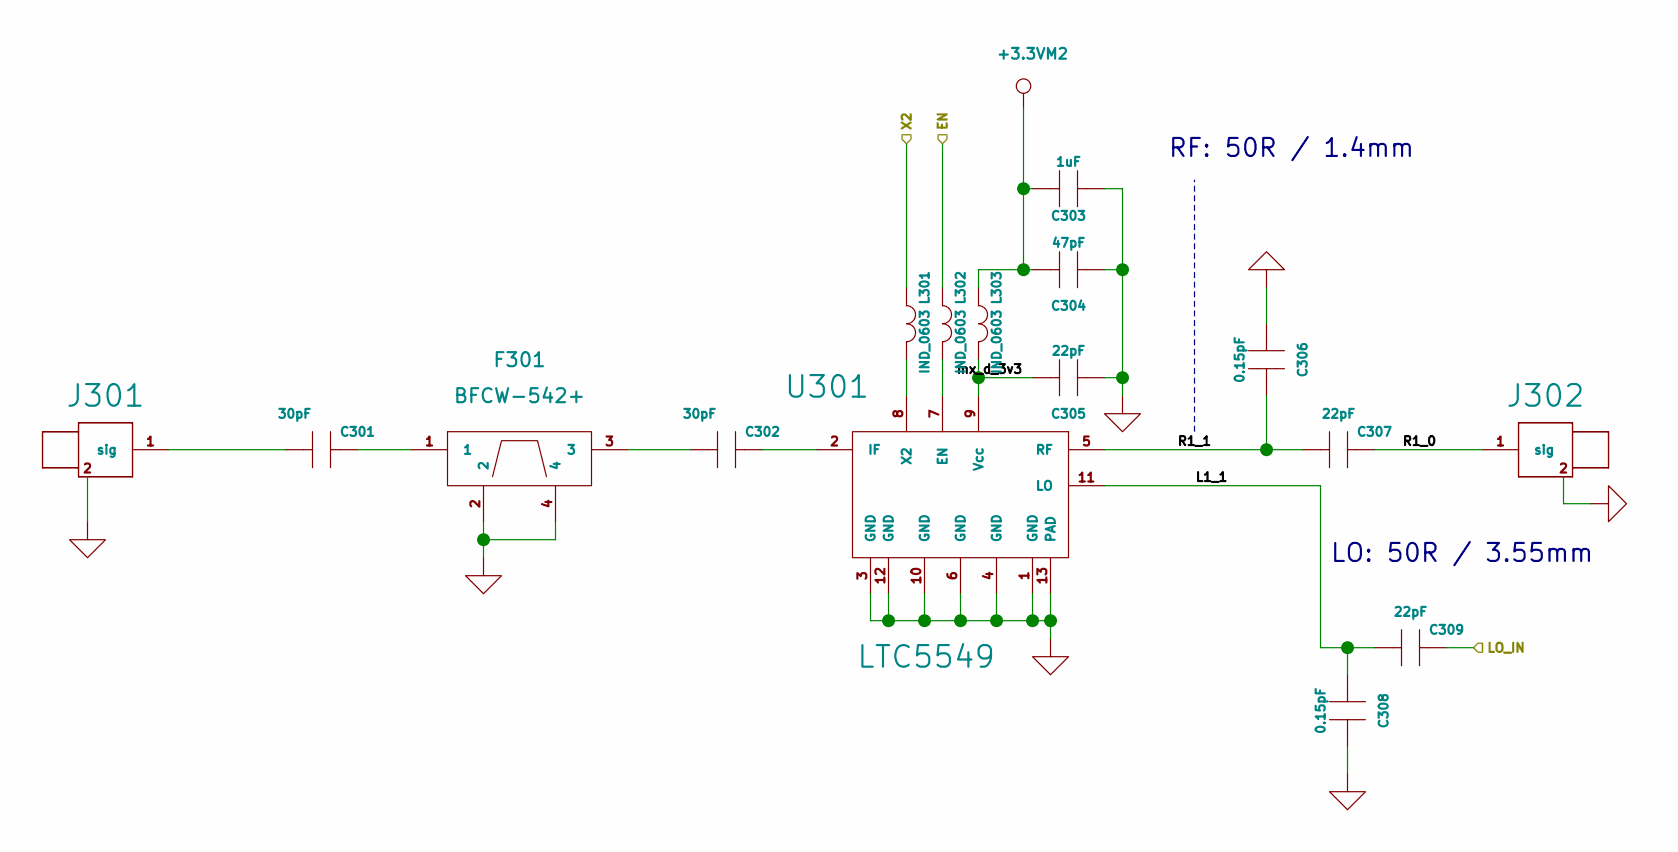
[picture p13: schematic mixer_2.sch, Digital 10 GHz Super Keyer]

Parts:
C301, C302: 30pF; SM0402
C303: 1uF; SM0603
C304: 47pF; SM0402
C305, C307, C309: 22pF; SM0402
C306, C308: 0.15pF; SM0402
F301: BFCW-542+; JC0603C
J301, J302: SMA_PCB; PAD_T_200x110um
L301, L302, L303: IND_0603; SM0603
U301: LTC5549; QFN12_2x3mm_UDB_LT

Connections:
+3.3VM2: C303.1, C304.2, L303.2; also elsewhere on the board
/ADF4355 PLL/LO_B: C309.1; also elsewhere on the board
/M2_EN: L302.2; also elsewhere on the board
/M2_X2: L301.2; also elsewhere on the board
/Mixer 2/L1_1: C308.1, C309.2, U301.11 (LO)
/Mixer 2/R1_0: C307.1, J302.1 (sig)
/Mixer 2/R1_1: C306.2, C307.2, U301.5 (RF)
/Mixer 2/mx_d_3v3: C305.2, L303.1, U301.9 (Vcc)
GND: C303.2, C304.1, C305.1, C306.1, C308.2, F301.2, F301.4, J301.2, J302.2, U301.1 (GND), U301.3 (GND), U301.4 (GND), U301.6 (GND), U301.10 (GND), U301.12 (GND), U301.13 (PAD); also elsewhere on the board
unnamed: C301.1, F301.1
unnamed: C301.2, J301.1 (sig)
unnamed: C302.1, U301.2 (IF)
unnamed: C302.2, F301.3
unnamed: L301.1, U301.8 (X2)
unnamed: L302.1, U301.7 (EN)

Notes on the sheet:
LO: 50R / 3.55mm
RF: 50R / 1.4mm
