PAPRST/digitensk/FrontEnd/DualMixer/Converter_Head/Converter_Head.kicad_pcb

## KiCad design FrontEnd/DualMixer/Converter_Head/Converter_Head.kicad_pcb (continued)

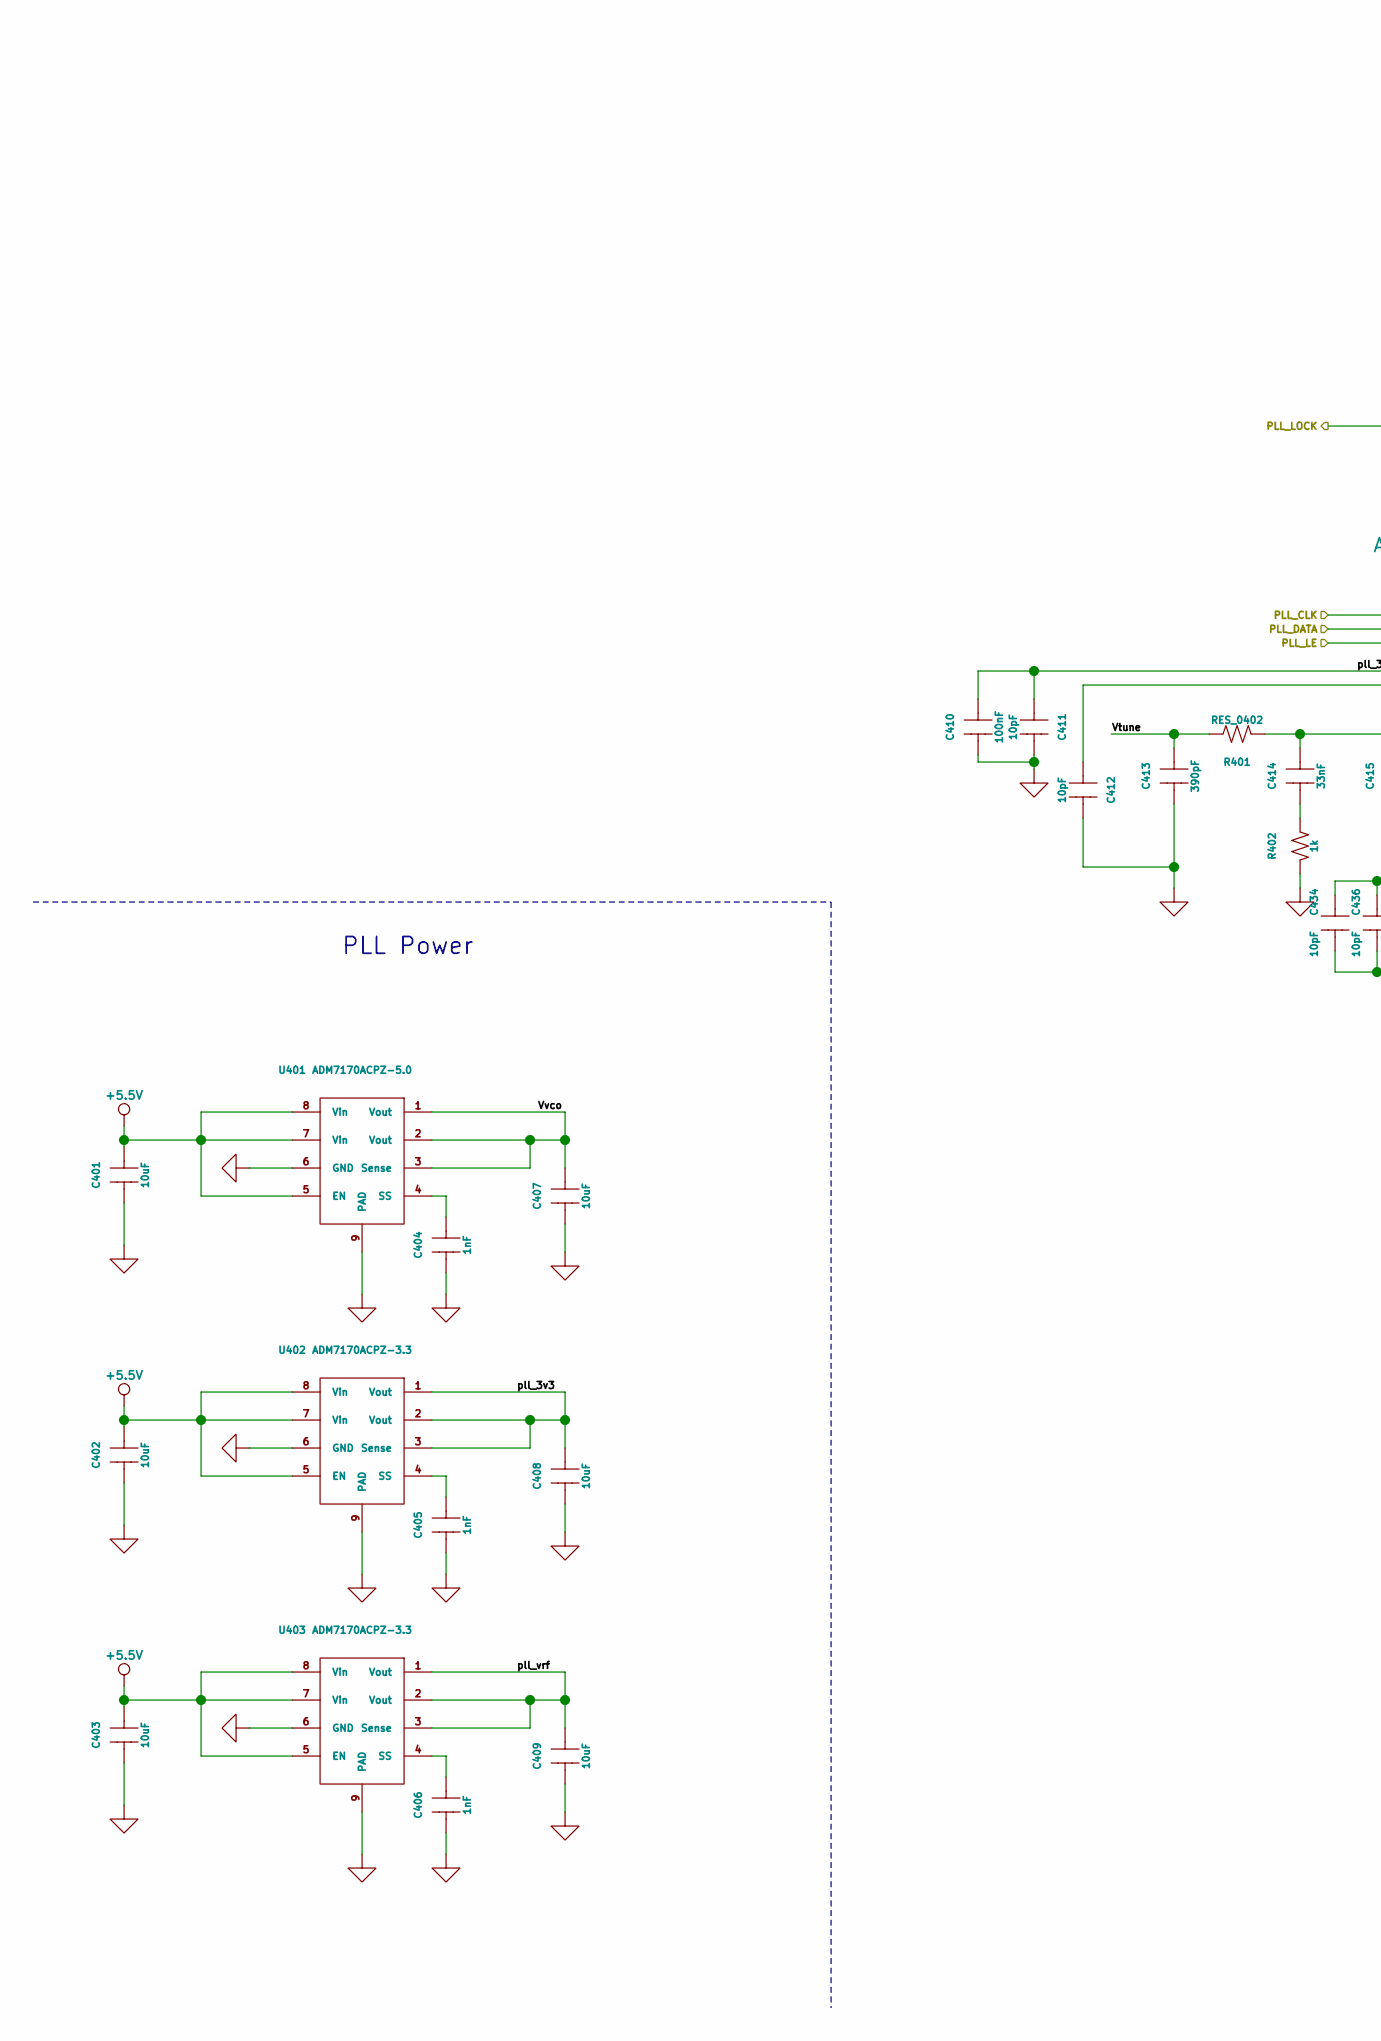
[picture p14: schematic ad4355.sch, part in row 1, column 1]

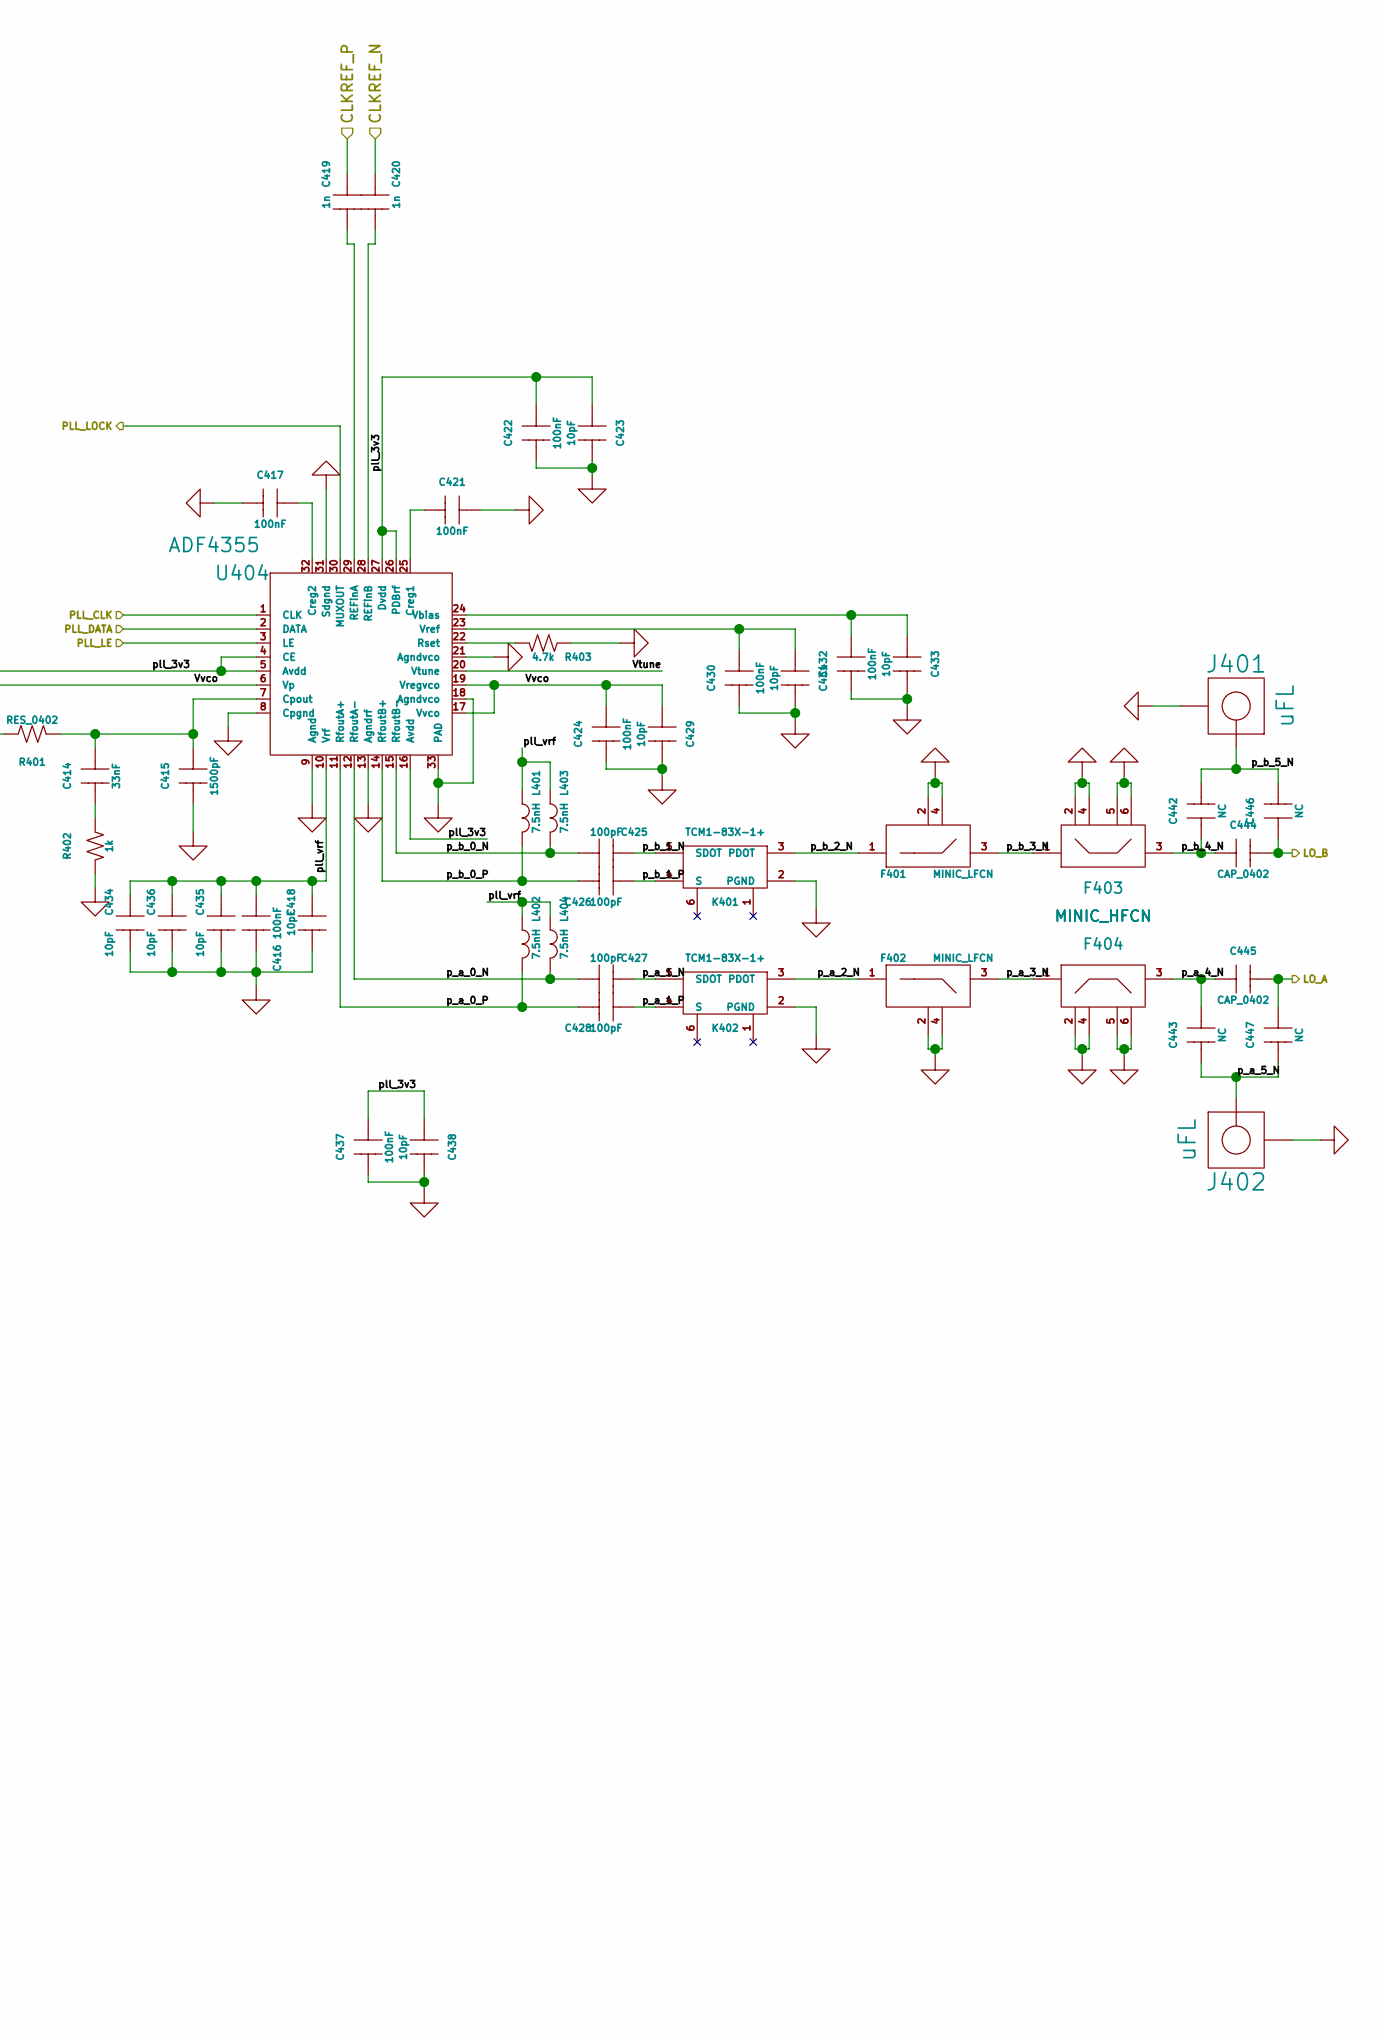
[picture p15: schematic ad4355.sch, part in row 1, column 2]

Parts:
C401, C402, C403, C407, C408, C409: 10uF; SM0805
C404, C405, C406: 1nF; SM0603
C410, C416, C417, C421, C422, C424, C430, C432, C437: 100nF; SM0402
C411, C412, C418, C423, C429, C431, C433, C434, C435, C436, C438: 10pF; SM0402
C413: 390pF; SM0402
C414: 33nF; SM0402
C415: 1500pF; SM0402
C419, C420: 1n; SM0402
C425, C426, C427, C428: 100pF; SM0402
C442, C443, C446, C447: NC; SM0402
C444, C445: CAP_0402; SM0402
F401, F402: MINIC_LFCN; FV1206
F403, F404: MINIC_HFCN; FV1206
J401, J402: uFL; U.FL-R-SMT-1
K401, K402: TCM1-83X-1+; DB1627
L401, L402, L403, L404: 7.5nH; SM0402
R401: RES_0402; SM0402
R402: 1k; SM0402
R403: 4.7k; SM0402
U401: ADM7170ACPZ-5.0; DFN8_3x3mm
U402, U403: ADM7170ACPZ-3.3; DFN8_3x3mm
U404: ADF4355; QFN32_5x5mm_3.6mm

Connections:
+5.5V: C401.1, C402.1, C403.1, U401.5 (EN), U401.7 (Vin), U401.8 (Vin), U402.5 (EN), U402.7 (Vin), U402.8 (Vin), U403.5 (EN), U403.7 (Vin), U403.8 (Vin); also elsewhere on the board
/ADF4355 PLL/CLKREF_N: C420.1; also elsewhere on the board
/ADF4355 PLL/CLKREF_P: C419.1; also elsewhere on the board
/ADF4355 PLL/LO_A: C445.2, C447.1; also elsewhere on the board
/ADF4355 PLL/LO_B: C444.2, C446.1; also elsewhere on the board
/ADF4355 PLL/Vtune: C413.1, R401.1, U404.20 (Vtune)
/ADF4355 PLL/Vvco: C407.1, C412.1, C424.1, C429.1, U401.1 (Vout), U401.2 (Vout), U401.3 (Sense), U404.6 (Vp), U404.17 (Vvco), U404.19 (Vregvco)
/ADF4355 PLL/p_a_0_N: C427.1, L404.2, U404.12 (RfoutA-)
/ADF4355 PLL/p_a_0_P: C428.2, L402.2, U404.11 (RfoutA+)
/ADF4355 PLL/p_a_1_N: C427.2, K402.5 (SDOT)
/ADF4355 PLL/p_a_1_P: C428.1, K402.4 (S)
/ADF4355 PLL/p_a_2_N: F402.1 (RFIN), K402.3 (PDOT)
/ADF4355 PLL/p_a_3_N: F402.3 (RFOUT), F404.1 (RFIN)
/ADF4355 PLL/p_a_4_N: C443.1, C445.1, F404.3 (RFOUT)
/ADF4355 PLL/p_a_5_N: C443.2, C447.2, J402.1 (RF)
/ADF4355 PLL/p_b_0_N: C425.1, L403.2, U404.15 (RfoutB-)
/ADF4355 PLL/p_b_0_P: C426.2, L401.2, U404.14 (RfoutB+)
/ADF4355 PLL/p_b_1_N: C425.2, K401.5 (SDOT)
/ADF4355 PLL/p_b_1_P: C426.1, K401.4 (S)
/ADF4355 PLL/p_b_2_N: F401.1 (RFIN), K401.3 (PDOT)
/ADF4355 PLL/p_b_3_N: F401.3 (RFOUT), F403.1 (RFIN)
/ADF4355 PLL/p_b_4_N: C442.1, C444.1, F403.3 (RFOUT)
/ADF4355 PLL/p_b_5_N: C442.2, C446.2, J401.1 (RF)
/ADF4355 PLL/pll_3v3: C408.1, C410.1, C411.1, C422.1, C423.1, C437.1, C438.1, U402.1 (Vout), U402.2 (Vout), U402.3 (Sense), U404.4 (CE), U404.5 (Avdd), U404.16 (Avdd), U404.26 (PDBrf), U404.27 (Dvdd)
/ADF4355 PLL/pll_vrf: C409.1, C416.1, C418.1, C434.1, C435.1, C436.1, L401.1, L402.1, L403.1, L404.1, U403.1 (Vout), U403.2 (Vout), U403.3 (Sense), U404.10 (Vrf)
/MOSI: U404.2 (DATA); also elsewhere on the board
/PLL_LOCK: U404.30 (MUXOUT); also elsewhere on the board
/SCK: U404.1 (CLK); also elsewhere on the board
/~PLL_CS: U404.3 (LE); also elsewhere on the board
GND: C401.2, C402.2, C403.2, C404.2, C405.2, C406.2, C407.2, C408.2, C409.2, C410.2, C411.2, C412.2, C413.2, C415.2, C416.2, C417.2, C418.2, C421.1, C422.2, C423.2, C424.2, C429.2, C430.2, C431.2, C432.2, C433.2, C434.2, C435.2, C436.2, C437.2, C438.2, F401.2 (GND), F401.4 (GND), F402.2 (GND), F402.4 (GND), F403.2 (GND), F403.4 (GND), F403.5 (GND), F403.6 (GND), F404.2 (GND), F404.4 (GND), F404.5 (GND), F404.6 (GND), J401.2 (GND), J402.2 (GND), K401.2 (PGND), K402.2 (PGND), R402.2, R403.1, U401.6 (GND), U401.9 (PAD), U402.6 (GND), U402.9 (PAD), U403.6 (GND), U403.9 (PAD), U404.8 (Cpgnd), U404.9 (Agnd), U404.13 (Agndrf), U404.18 (Agndvco), U404.21 (Agndvco), U404.31 (Sdgnd), U404.33 (PAD); also elsewhere on the board
unnamed: C404.1, U401.4 (SS)
unnamed: C405.1, U402.4 (SS)
unnamed: C406.1, U403.4 (SS)
unnamed: C414.1, C415.1, R401.2, U404.7 (Cpout)
unnamed: C414.2, R402.1
unnamed: C417.1, U404.32 (Creg2)
unnamed: C419.2, U404.29 (REFinA)
unnamed: C420.2, U404.28 (REFinB)
unnamed: C421.2, U404.25 (Creg1)
unnamed: C430.1, C431.1, U404.23 (Vref)
unnamed: C432.1, C433.1, U404.24 (Vbias)
unnamed: R403.2, U404.22 (Rset)

Notes on the sheet:
PLL Power

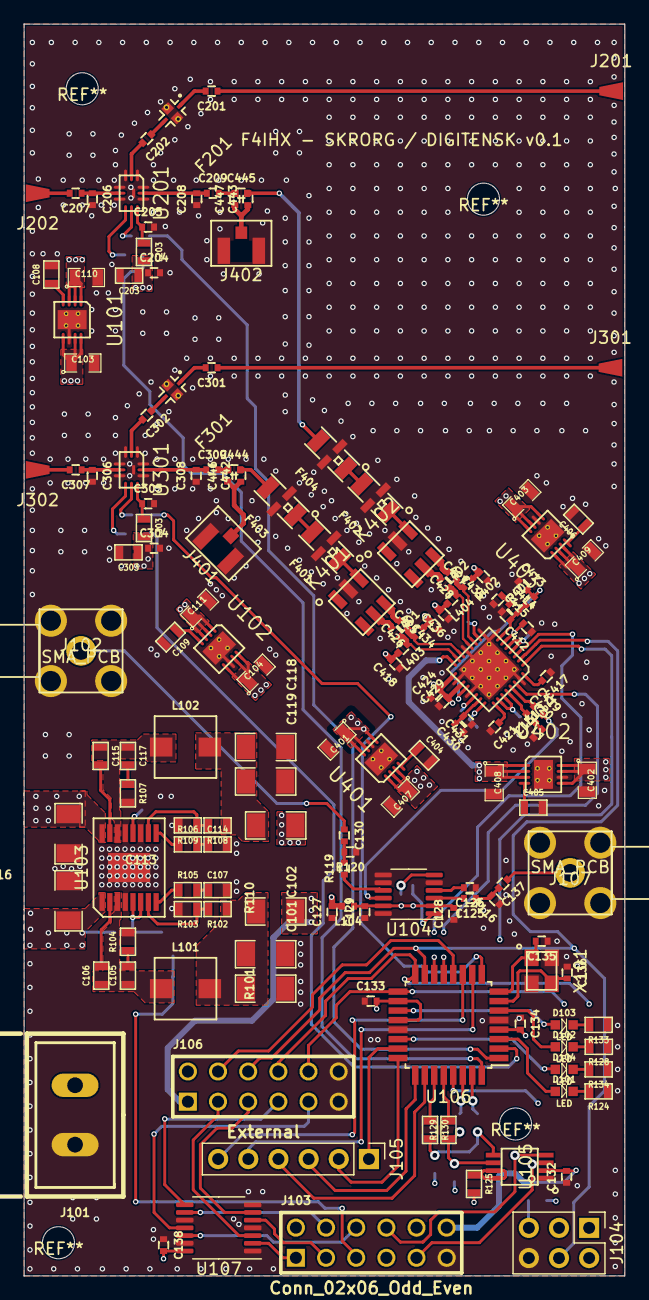
[picture p16: board Converter_Head.kicad_pcb from above]

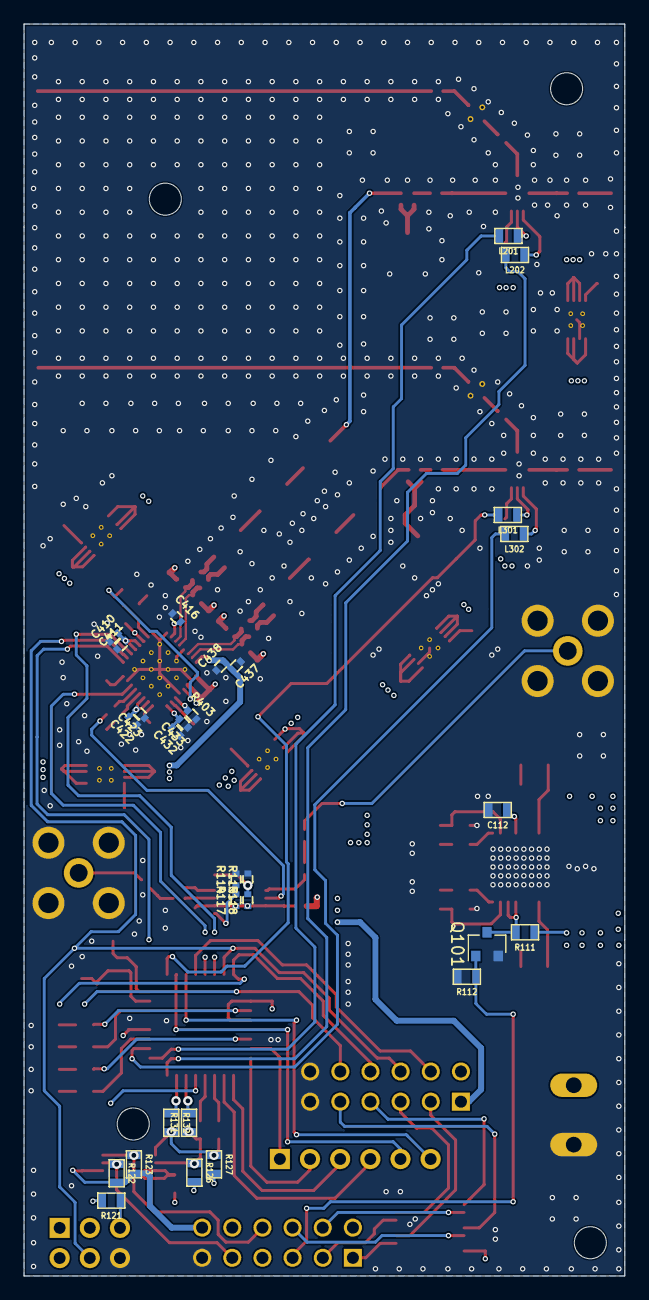
[picture p17: board Converter_Head.kicad_pcb from below]

Board: 4 copper layers, 50.6 x 105.5 mm, 184 parts (29 on the bottom side), 136 nets.
