PAPRST/digitensk/(commit log)

2020-10-04 starting layout
    [Converter_Head.kicad_pcb, Converter_Head.sch, ad4355.sch, mixer_1.sch, mixer_2.sch]
2020-10-05 Added power, needs to add communication connector
    [Converter_Head.sch, ad4355.sch, mixer_1.sch, mixer_2.sch]
2021-06-06 sent in production
    [Converter_Head.sch, ad4355.sch, mixer_1.sch, mixer_2.sch]
2021-07-17 writing avr code
    [Converter_Head.kicad_pcb, Converter_Head_bom_1.0.csv]
